Hengy/RelayAnalyzerHardware/Hardware Block Diagram.jpg

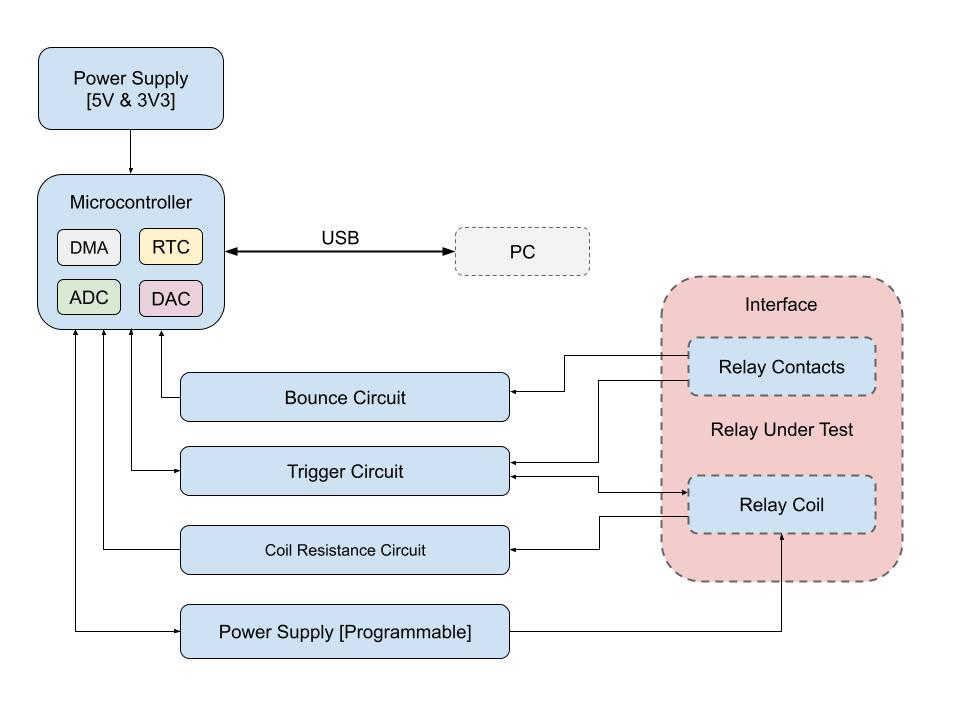
Hardware Block Diagram.jpg
