Hengy/RelayAnalyzerHardware/Photos/Programmable Power Supply.jpg

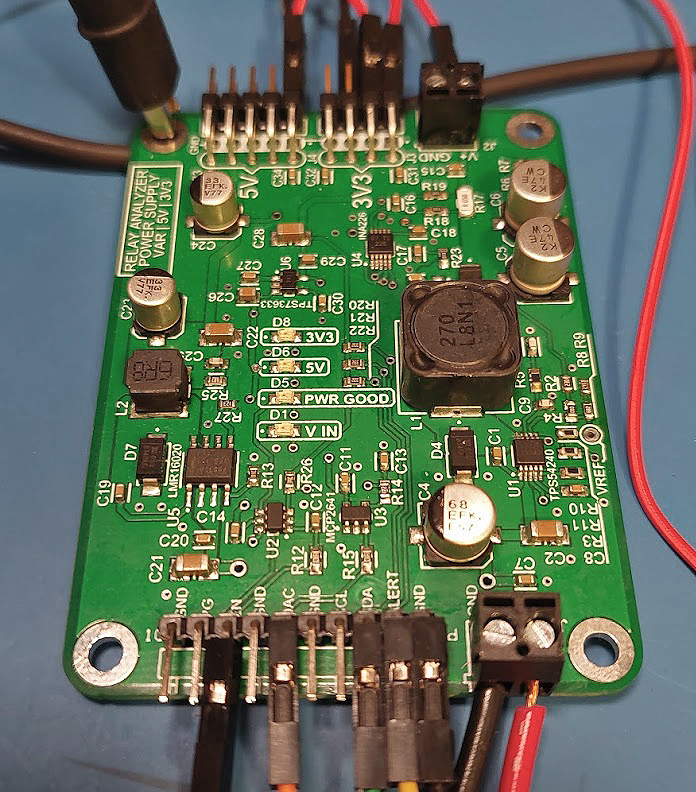
Photos/Programmable Power Supply.jpg
