Hengy/RelayAnalyzerHardware/Photos/STM32F767 Nucleo.jpg

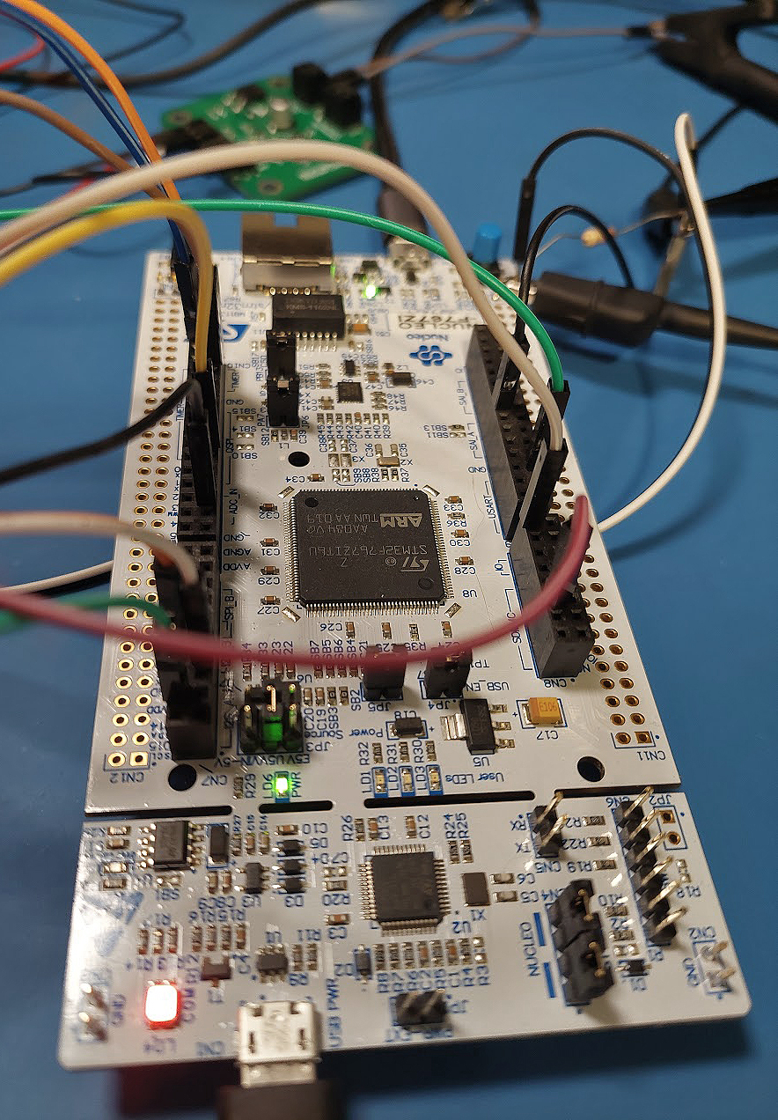
Photos/STM32F767 Nucleo.jpg
