Hengy/RelayAnalyzerHardware/Photos/Trigger.jpg

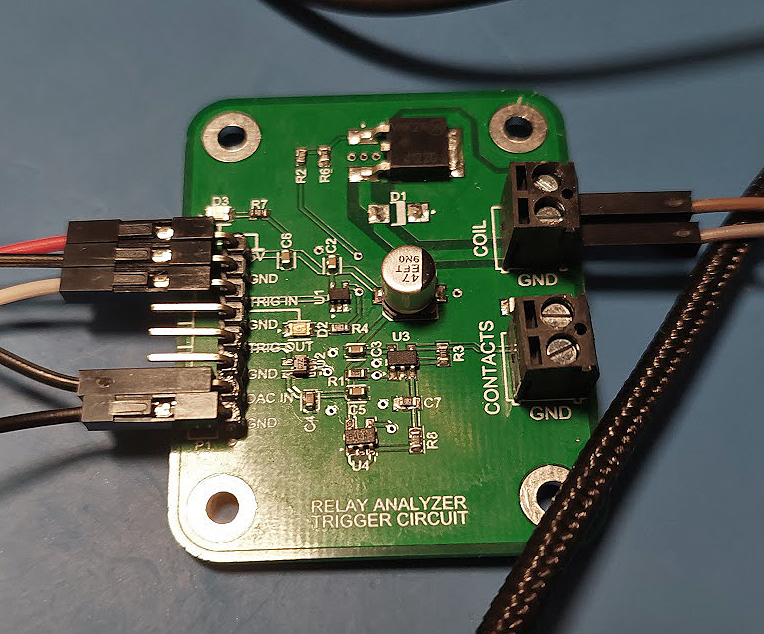
Photos/Trigger.jpg
