Hengy/RelayAnalyzerHardware/Trigger Circuit/PCB.jpg

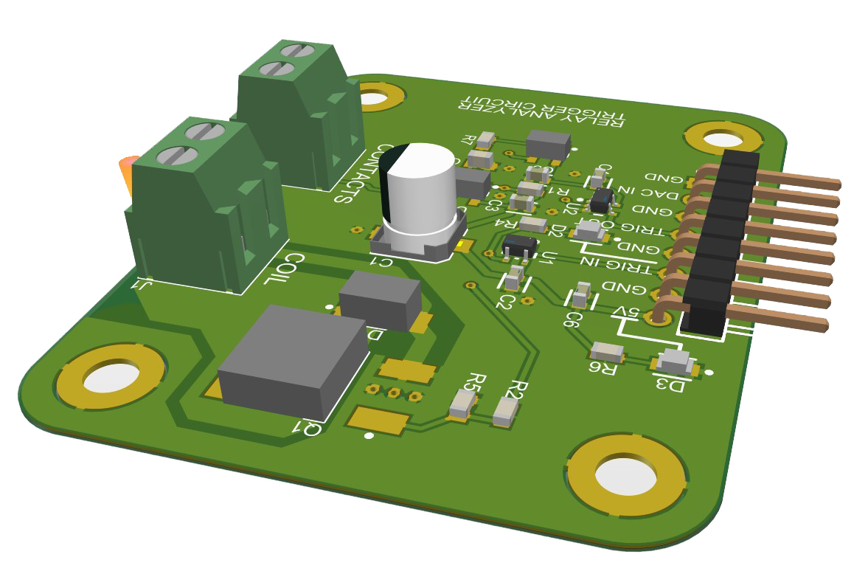
Trigger Circuit/PCB.jpg
