Hengy/RelayAnalyzerHardware/Programmable Power Supply/BOM.xlsx

Designator | Quantity | Comment | Description | PartType | Case Code (Imperial) | Case/Package | Package | PackageDescription | PackageReference | Manufacturer
C1, C3, C7, C11, C12, C14, C15, C17, C18, C19, C20, C27, C29, C31, C32, C33, C34 | 17 | CL10B104KA8NFNC | Cap Ceramic 100nF 25V X7R ±10% Pad SMD 0603 +125°C T/R | CL10B104KA8NFNC | 0603 | 0603
C2, C21, C22, C28 | 4 | GCJ31CR71E475KA12L | Cap Ceramic 4.7uF 25V X7R 10% Pad SMD 1206 Soft Termination +125°C Automotive T/R | GCJ31CR71E475KA12L | 1206 | 1206
C4 | 1 | UUD1E680MCL1GS | Aluminum Electrolytic Capacitor, UD Series, Low Impedance, 68 uF, 25 V, + / - 20%, -55 to 105 degC, Chip Type, 6.3 x 5.8 mm D x L, Pb-Free, Reel | UUD1E680MCL1GS |  |  |  | 2-Pin Surface Mount Device, Diameter 6.3 mm, Height 5.8 mm, Pitch 5.4 mm | CAPAE-D6.3H5.8 | Nichicon
C5, C6 | 2 | UUD1E470MCL1GS | Aluminum Electrolytic Capacitor, UD Series, Low Impedance, 47 uF, 25 V, + / - 20%, -55 to 105 degC, Chip Type, 6.3 x 5.8 mm D x L, Pb-Free, Reel | UUD1E470MCL1GS |  |  |  | 2-Pin Surface Mount Device, Diameter 6.3 mm, Height 5.8 mm, Pitch 5.4 mm | CAPAE-D6.3H5.8 | Nichicon
C8 | 1 | 06035C103MAT2A |  | 06035C103MAT2A |  |  |  |  |  | AVX Interconnect / Elco
C9 | 1 | CL10C220JB8NNNC | Chip Capacitor, 22 pF, +/- 5%, 50 V, -55 to 125 degC, 0603 (1608 Metric), RoHS, Tape and Reel | CL10C220JB8NNNC |  |  |  |  |  | Samsung Electro-Mechanics
C10 | 1 | CL10B392KB8NNND | Cap Ceramic 3.9nF 50V X7R ±10% Pad SMD 0603 +125°C T/R | CL10B392KB8NNND |  | 0603
C13, C30 | 2 | CL10B103MB8NNNC | Cap Ceramic 10nF 50V X7R ±20% Pad SMD 0603 +125°C T/R | CL10B103MB8NNNC | 0603 | 0603
C16 | 1 | C0603C104J4RACTU | CAP CER 0.1UF 16V X7R 0603 | C0603C104J4RACTU |  |  | C0603C-CF |  |  | KEMET
C23, C24 | 2 | UUD1A330MCL1GS | Aluminum Electrolytic Capacitor, UD Series, Low Impedance, 33 uF, 10 V, + / - 20%, -55 to 105 degC, Chip Type, 5 x 5.8 mm D x L, Pb-Free, Reel | UUD1A330MCL1GS |  |  |  | 2-Pin Surface Mount Device, Diameter 5 mm, Height 5.8 mm, Pitch 4.4 mm | CAPAE-D5H5.8 | Nichicon
C25 | 1 | GRM1885C1H221JA01J |  | GRM1885C1H221JA01J |  |  |  |  |  | Murata
C26 | 1 | CL21A225KPCLNNC | CL21 Series 0805 2.2uF 10V ±10% Tolerance X5R Multilayer Ceramic Chip Capacitor | CL21A225KPCLNNC | 0805 | 0805
D1, D5, D6, D8 | 4 | LTST-C171GKT | LED GREEN CLEAR CHIP SMD | LTST-C171GKT | 0805 | 0805
D2 | 1 | MBRA160T3G | Schottky Power Rectifier, 2-Pin SMA, Pb-Free, Tape and Reel | MBRA160T3G |  |  |  | 2-Pin Small Molded Package, J-Bend Lead, Body 2.605 x 4.315 mm | SMA-2-403D-02 | On Semiconductor
D3 | 1 | MBR130T1G | Schottky Power Rectifier, 2-Pin SOD-123, Pb-Free, Tape and Reel | MBR130T1G |  |  |  | 2-Pin SOD, Body 1.6 x 2.69 mm | SOD-123-2-425-04 | On Semiconductor
D4, D7 | 2 | SS14 | DIODE SCHOTTKY 40V 1A SMA | SS14 |  |  | 403AE |  |  | ON Semiconductor
J1, J2 | 2 | 691103110002 | Series 1031 - 3.50 mm Horizontal Entry Modular with Pressure Clamp WR-TBL, 2 pin | 691103110002 |  |  |  |  |  | Wurth Elektronik
J3 | 1 | TSW-104-08-T-D-RA | CONN HEADER R/A 8POS 2.54MM | TSW-104-08-T-D-RA |  |  | TSW-104-08-T-D-RA |  |  | Samtec
J4 | 1 | TSW-105-08-L-D-RA | CONN HEADER R/A 10POS 2.54MM | TSW-105-08-L-D-RA |  |  | TSW-105-08-L-D-RA |  |  | Samtec
L1 | 1 | CDRH127NP-100MC | Power Inductor, 10 uH, +/- 20%, -40 to 100 degC, 2-Pin SMD, RoHS, Tape and Reel | CDRH127NP-100MC |  |  |  |  |  | Sumida
L2 | 1 | SRN6045-2R2Y | Semi-Shielded Power Inductor, 2.2 uH, +/- 30%, 3.5 A, -40 to 125 degC, 2-Pin SMD, RoHS, Tape and Reel | SRN6045-2R2Y |  |  |  |  |  | Bourns
P1 | 1 | 61301011021 | THT Angled Pin Header WR-PHD, Pitch 2.54 mm, Single Row, 10 pins | 61301011021 |  |  |  |  |  | Wurth Elektronik
R1 | 1 | RC1608F682CS | Res Thick Film 0603 6.8kΩ 1% 0.1W ±100ppm/°C Molded SMD T/R | RC1608F682CS | 0603 | 0603
R2 | 1 | CRCW0603169KFKEA | RES Thick Film, 169kΩ, 1%, 0.1W, 100ppm/°C, 0603 | CRCW0603169KFKEA | 0603 | 0603
R3 | 1 | ERJ-3EKF1623V |  | ERJ-3EKF1623V |  |  |  |  |  | Panasonic
R4, R11 | 2 | ERJ-3EKF2551V |  | ERJ-3EKF2551V |  |  |  |  |  | Panasonic
R5 | 1 | 68K1 1% 0603(1608) | 68K1 0.1W 1% 0603 (1608 Metric) SMD | 68K1 1% 0603(1608)
R6, R7 | 2 | RC3216J102CS | Res Thick Film 1206 1kΩ 5% 0.25W ±100ppm/°C Molded SMD T/R | RC3216J102CS | 1206 | 1206
R8, R9 | 2 | RC0603FR-135K6L |  | RC0603FR-135K6L |  |  |  |  |  | Yageo
R10 | 1 | RC1608F753CS | Res Thick Film 0603 75kΩ 1% 0.1W ±100ppm/°C Molded SMD T/R | RC1608F753CS | 0603 | 0603
R12, R15 | 2 | CRCW0603100RFKEB | RES Thick Film, 100Ω, 1%, 0.1W, 100ppm/°C, 0603 | CRCW0603100RFKEB | 0603 | 0603
R13 | 1 | CRCW060310K0JNEB | RES Thick Film, 10kΩ, 5%, 0.1W, 200ppm/°C, 0603 | CRCW060310K0JNEB | 0603 | 0603
R14 | 1 | 3K3 5% 0603(1608) | 3K3 0.1W 5% 0603 (1608 Metric) SMD | 3K3 5% 0603(1608)
R16 | 1 | ERJ-3GEYJ681V |  | ERJ-3GEYJ681V |  |  |  |  |  | Panasonic
R17 | 1 | RP73D2B100RBTDF | Res Thin Film 1206 100Ω 0.1% 0.25W 15ppm/°C Molded SMD | RP73D2B100RBTDF |  |  | RP732B |  |  | TE Connectivity
R18, R19, R23 | 3 | TNPW060310R0FHTA |  | TNPW060310R0FHTA |  |  |  |  |  | Vishay Dale
R20, R21, R22 | 3 | ERJ-3GEYJ332V |  | ERJ-3GEYJ332V |  |  |  |  |  | Panasonic
R24 | 1 | AC0603FR-071K3L | RES SMD 1.3K OHM 1% 1/10W 0603 | AC0603FR-071K3L |  |  | AC0603 |  |  | Yageo
R25 | 1 | CRCW060368K0FKEA | RES Thick Film, 68kΩ, 1%, 0.1W, 100ppm/°C, 0603 | CRCW060368K0FKEA | 0603 | 0603
R26 | 1 | CRCW060322K1FKTA |  | CRCW060322K1FKTA |  |  |  |  |  | Vishay Dale
R27 | 1 | RC0603FR-1312KL |  | RC0603FR-1312KL |  |  |  |  |  | Yageo
R28 | 1 | ERJ-3GEYJ561V |  | ERJ-3GEYJ561V |  |  |  |  |  | Panasonic
U1 | 1 | TPS54240DGQR | Buck Inverting Buck-Boost Step Down Regulator with 3.5 to 42 V Input and 0.8 to 39 V Output, -40 to 150 degC, 10-Pin MSOP-PowerPAD (DGQ), Green (RoHS & no Sb/Br) | TPS54240DGQR |  |  |  | 10-Pin PowerPAD Plastic Small Outline 0.5 mm Pitch, Exposed Pad | DGQ0010D | Texas Instruments
U2 | 1 | SN74LVC2G17DBVR | Dual Schmitt-Trigger Buffer, DBV0006A, LARGE T&R | SN74LVC2G17DBVR |  |  |  |  | DBV0006A | Texas Instruments
U3 | 1 | MCP6241T-E/OT | 20 uA, 300 KHz Rail-to-Rail Operational Amplifier, 5-Pin SOT-23, Extended Temperature, Tape and Reel | MCP6241T-E/OT |  |  |  | 5-Lead Plastic Small Outline Transistor (OT) [SOT-23] | SOT-23-OT5
U4 | 1 | INA226AIDGST | High-Side Measurement, Bi-Directional Current / Power Monitor with I2C Interface, 2.7 to 5.5 V, -40 to 125 degC, 10-pin SOP (DGS10), Green (RoHS & no Sb/Br) | INA226AIDGST |  |  |  | 10-Pin Plastic Small Outline, Body 3 x 3 mm, Pitch 0.5 mm | DGS0010A
U5 | 1 | LMR16020PDDAR | IC REG BUCK ADJUSTABLE 2A 8SOPWR | LMR16020PDDAR |  |  | DDA0008E |  |  | Texas Instruments
U6 | 1 | TPS73633DBVT | Single Output Low Noise LDO, 400 mA, Fixed 3.3 V Output, 1.7 to 5.5 V Input, with Reverse Current Protection, 5-pin SOT-23 (DBV), -40 to 85 degC, Green (RoHS & no Sb/Br) | TPS73633DBVT |  |  |  | 5-Pin Plastic Small Outline, Body 1.60 Ãƒâ€” 2.90 mm, Pitch 0.95 mm | DBV0005A | Texas Instruments
