Hengy/RelayAnalyzerHardware/Relay Interface/BOM.xlsx

Comment | Description | Designator | Quantity | Case/Package | Case Code (Imperial) | Package | PackageDescription | PartType | Manufacturer
CL10B104KB8NNNC | Multi-layer Ceramic Capacitor, -55 to 125 degC, 2-Pin SMD (0603), RoHS, Tape and Reel | C1, C3, C4, C6 | 4 |  |  |  |  | CL10B104KB8NNNC | Samsung Electro-Mechanics
UUD1C680MCL1GS | Aluminum Electrolytic Capacitor, UD Series, Low Impedance, 68 uF, 16 V, + / - 20%, -55 to 105 degC, Chip Type, 6.3 x 5.8 mm D x L, Pb-Free, Reel | C2 | 1 |  |  |  | 2-Pin Surface Mount Device, Diameter 6.3 mm, Height 5.8 mm, Pitch 5.4 mm | UUD1C680MCL1GS | Nichicon
GRM31CR61E106KA12L | Chip Capacitor, 10 uF, +/- 10%, 25 V, -55 to 85 degC, 1206 (3216 Metric), RoHS, Tape and Reel | C5 | 1 |  |  |  |  | GRM31CR61E106KA12L | Murata
LTST-C171KGKT | LED GREEN CLEAR SMD | D1 | 1 | 0805 | 0805 |  |  | LTST-C171KGKT
LTST-C171GKT | LED GREEN CLEAR CHIP SMD | D2 | 1 | 0805 | 0805 |  |  | LTST-C171GKT
ES3AB-13-F | DIODE GEN PURP 50V 3A SMB | D3 | 1 |  |  | SMB |  | ES3AB-13-F | Diodes
691214110002 | Serie 2141 - 3.50 mm Horizontal Entry Modular with Rising Cage Clamp WR-TBL, 2 pin | J1, J3, J4, J5, J6, J7, J8, J9 | 8 |  |  |  |  | 691214110002 | Wurth Elektronik
90121-0768 | CONN HEADER R/A 8POS 2.54MM | J2 | 1 |  |  | HDR8 |  | 90121-0768 | Molex
CRCW06030000Z0EC |  | R1 | 1 |  |  |  |  | CRCW06030000Z0EC | Vishay Dale
RT0603BRD07560RL | RES SMD 560 OHM 0.1% 1/10W 0603 | R2, R3 | 2 |  |  | RT0603 |  | RT0603BRD07560RL | Yageo
RT0603BRD071K8L | RES SMD 1.8K OHM 0.1% 1/10W 0603 | R4, R5, R7, R8, R9 | 5 |  |  | RT0603 |  | RT0603BRD071K8L | Yageo
SN74LVC3G17DCUR | IC BUFFER NON-INVERT 5.5V US8 | U1, U2 | 2 |  |  | DCU0008A |  | SN74LVC3G17DCUR | Texas Instruments
CPC1019N | Dual FET DC Solid State Relay | U3, U4, U6, U7, U8 | 5 |  |  |  |  | CPC1019N
