Hengy/RelayAnalyzerHardware/Trigger Circuit/BOM.xlsx

Designator | Quantity | Comment | Description | Case/Package | Case Code (Imperial) | Manufacturer Part Number | Package | PackageDescription | PartType | Manufacturer
C1 | 1 | EEE-FT1E470AR | Aluminum Electrolytic Capacitor, 47 uF +/- 20%, 25 V, -55 to 105 degC, 2-Pin 5.3 x 5.3 x 6.1 mm SMD, RoHS, Tape and Reel |  |  |  |  | 2-Pin SMD, Body 5.3 x 5.3 mm, Height 6.1 mm | EEE-FT1E470AR | Panasonic
C2, C3, C4, C5, C6 | 5 | C0603C104K4RACTU | Capacitor; Ceramic; Cap; .100uF; Tol 10%; SMT; Vol-Rtg 16V; X7R; Tape and Reel |  |  | C0603C104K4RACTU | C0603C-CF |  | C0603C104K4RACTU | KEMET
C7 | 1 | VJ0603Y222KXACW1BC |  |  |  |  |  |  | VJ0603Y222KXACW1BC | Vitramon
D1 | 1 | 1SMA5913BT3G | 1.5 W Zener Voltage Regulator, 2-Pin SMA, Pb-Free, Tape and Reel |  |  |  |  | 2-Pin Small Molded Package, J-Bend Lead, Body 2.605 x 4.315 mm | 1SMA5913BT3G | On Semiconductor
D2, D3 | 2 | SML-LXT0805IW-TR | LED RED DIFFUSED SMD | 0805 | 0805 |  |  |  | SML-LXT0805IW-TR
J1, J2 | 2 | 691214110002 | Serie 2141 - 3.50 mm Horizontal Entry Modular with Rising Cage Clamp WR-TBL, 2 pin |  |  |  |  |  | 691214110002 | Wurth Elektronik
P1 | 1 | 61300811021 | THT Angled Pin Header WR-PHD, Pitch 2.54 mm, Single Row, 8 pins |  |  |  |  |  | 61300811021 | Wurth Elektronik
Q1 | 1 | MJD122T4G | Complementary Darlington Power Transistor, 3-Pin DPAK, Pb-Free, Tape and Reel |  |  |  |  | 3-Pin Flange Mount, Body 6.54 x 6.095 mm, Pitch 2.29 mm | MJD122T4G | On Semiconductor
R1, R4, R7 | 3 | ERJ-3EKF1001V |  |  |  |  |  |  | ERJ-3EKF1001V | Panasonic
R2 | 1 | ERJ-3EKF1000V |  |  |  |  |  |  | ERJ-3EKF1000V | Panasonic
R3, R6 | 2 | ERJ-3GEYJ103V |  |  |  |  |  |  | ERJ-3GEYJ103V | Panasonic
R5 | 1 | RC3216J102CS | Res Thick Film 1206 1kΩ 5% 0.25W ±100ppm/°C Molded SMD T/R | 1206 | 1206 |  |  |  | RC3216J102CS
R8 | 1 | ERJ-3GEYJ332V |  |  |  |  |  |  | ERJ-3GEYJ332V | Panasonic
U1, U2 | 2 | 74LVC1G17SE-7 | IC BUF NON-INVERT 5.5V SOT353 |  |  | 74LVC1G17SE-7 | SOT353 |  | 74LVC1G17SE-7 | Diodes
U3 | 1 | MCP6561RT-E/OT | 1.8V Low Power Push-Pull Output Comparator, 5-Pin SOT-23, Extended Temperature Range, Tape and Reel |  |  |  |  | 5-Lead Plastic Small Outline Transistor (OT) [SOT-23] | MCP6561RT-E/OT
U4 | 1 | MCP6001T-E/OT | 1 MHz, Low-Power Operational Amplifier, 5-Pin SOT-23, Extended Temperature, Tape and Reel |  |  |  |  | 5-Lead Plastic Small Outline Transistor (OT) [SOT-23] | MCP6001T-E/OT
