Hengy/RelayAnalyzerHardware/Photos/Test Setup.jpg

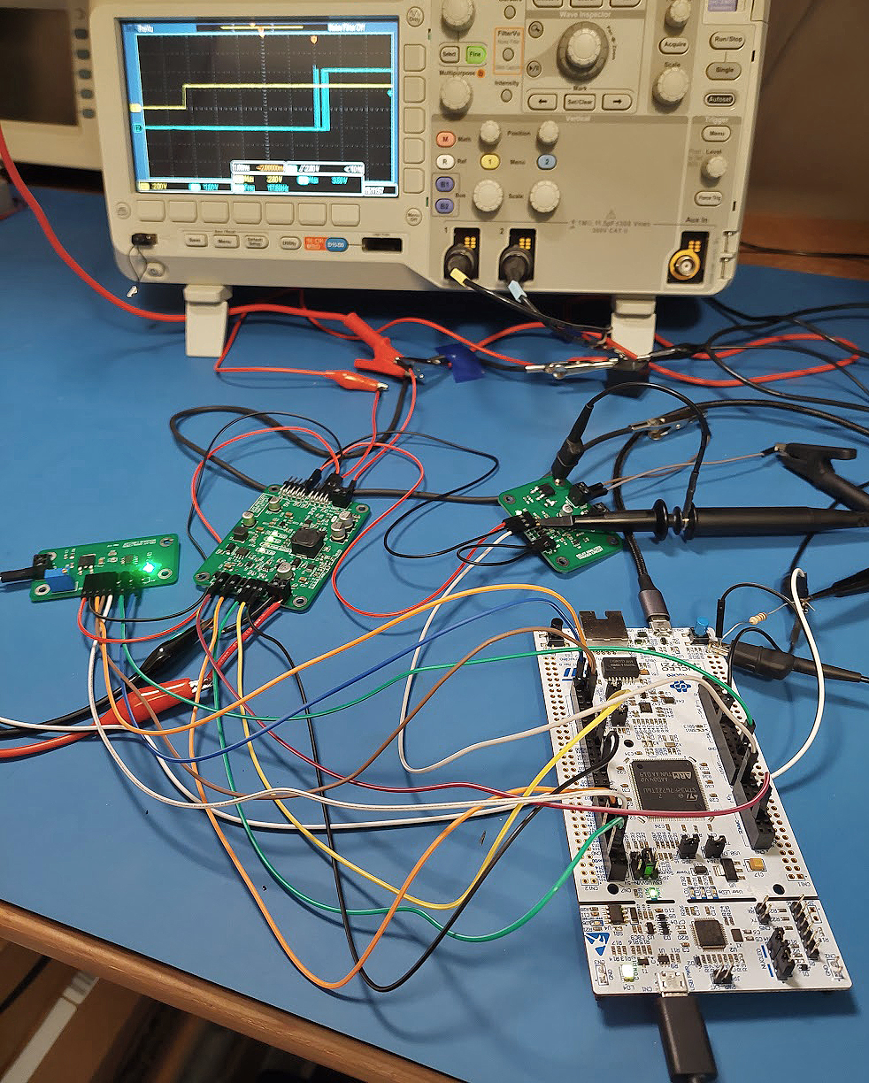
Photos/Test Setup.jpg
