Hengy/RelayAnalyzerHardware/Programmable Power Supply/Schematics and PCB.pdf

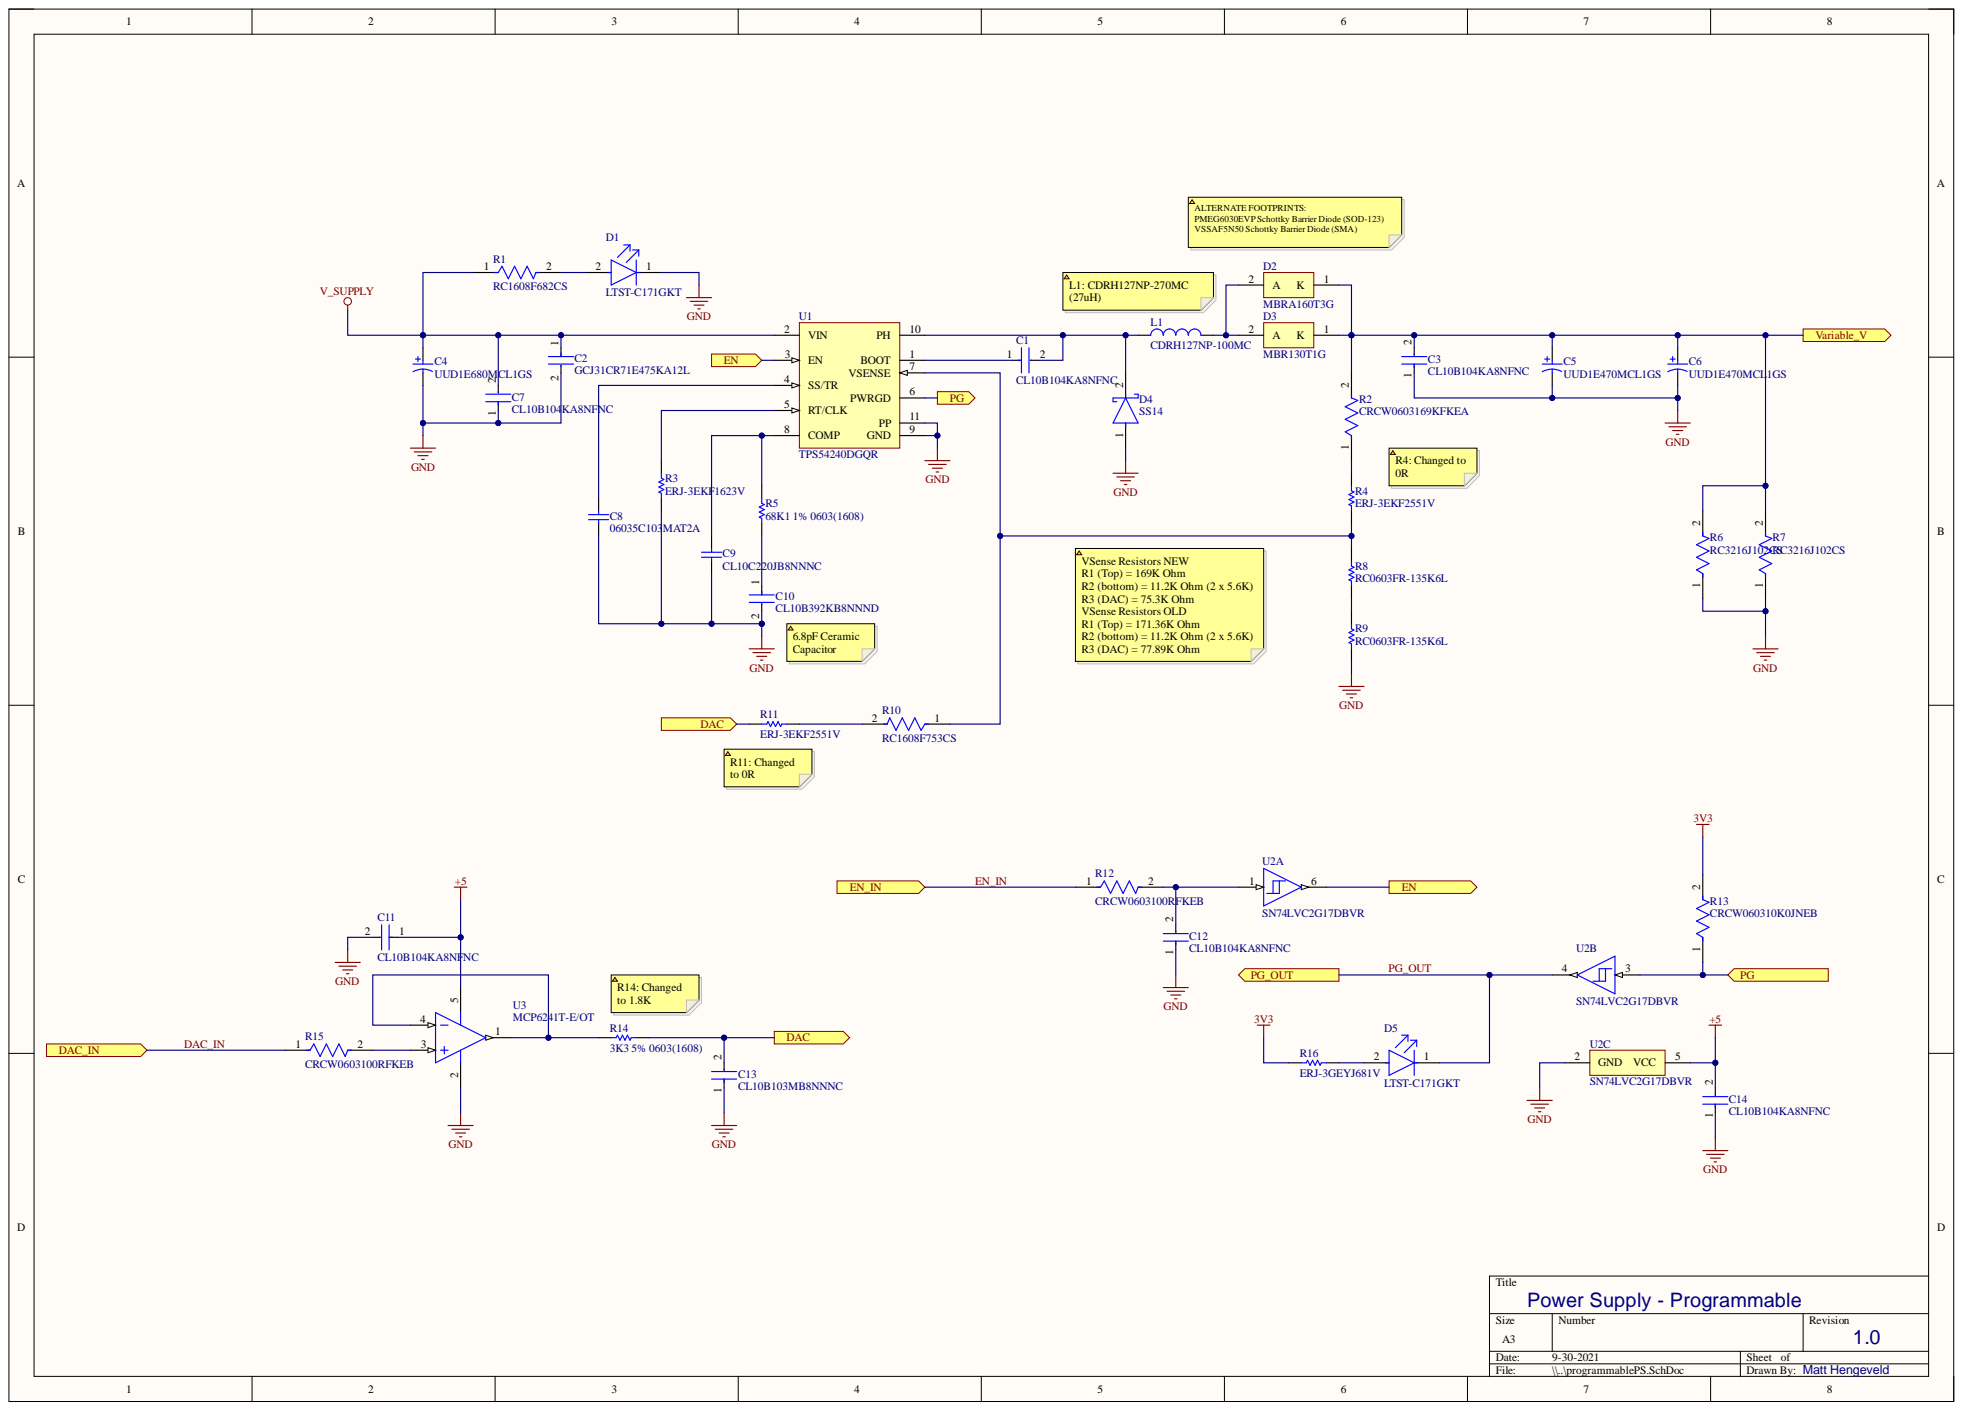
[picture p27: page 1]

ALTERNATE FOOTPRINTS:
PMEG6030EVPSchottky Barrier Diode (SOD-123)
VSSAF5N50 Schottky Barrier Diode (SMA)

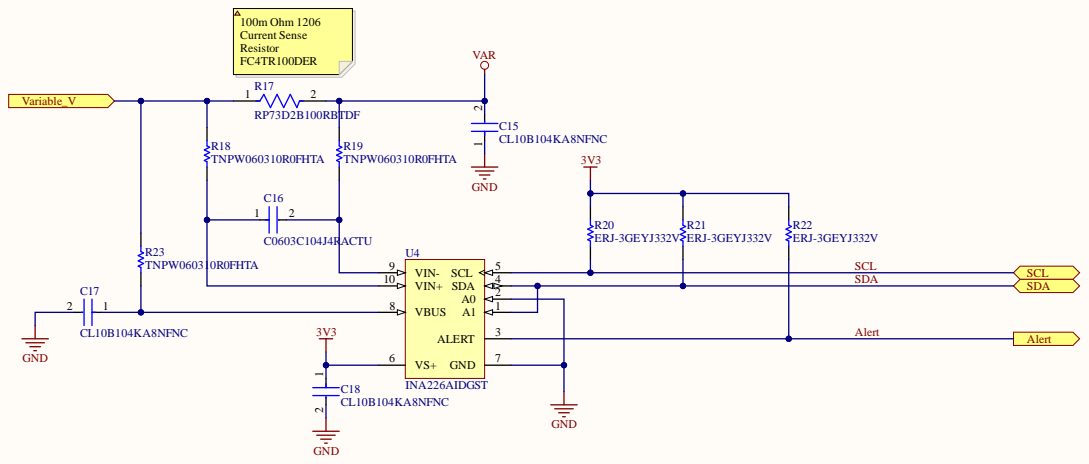
[picture p28: page 2]

Power Supply - Current Monitor

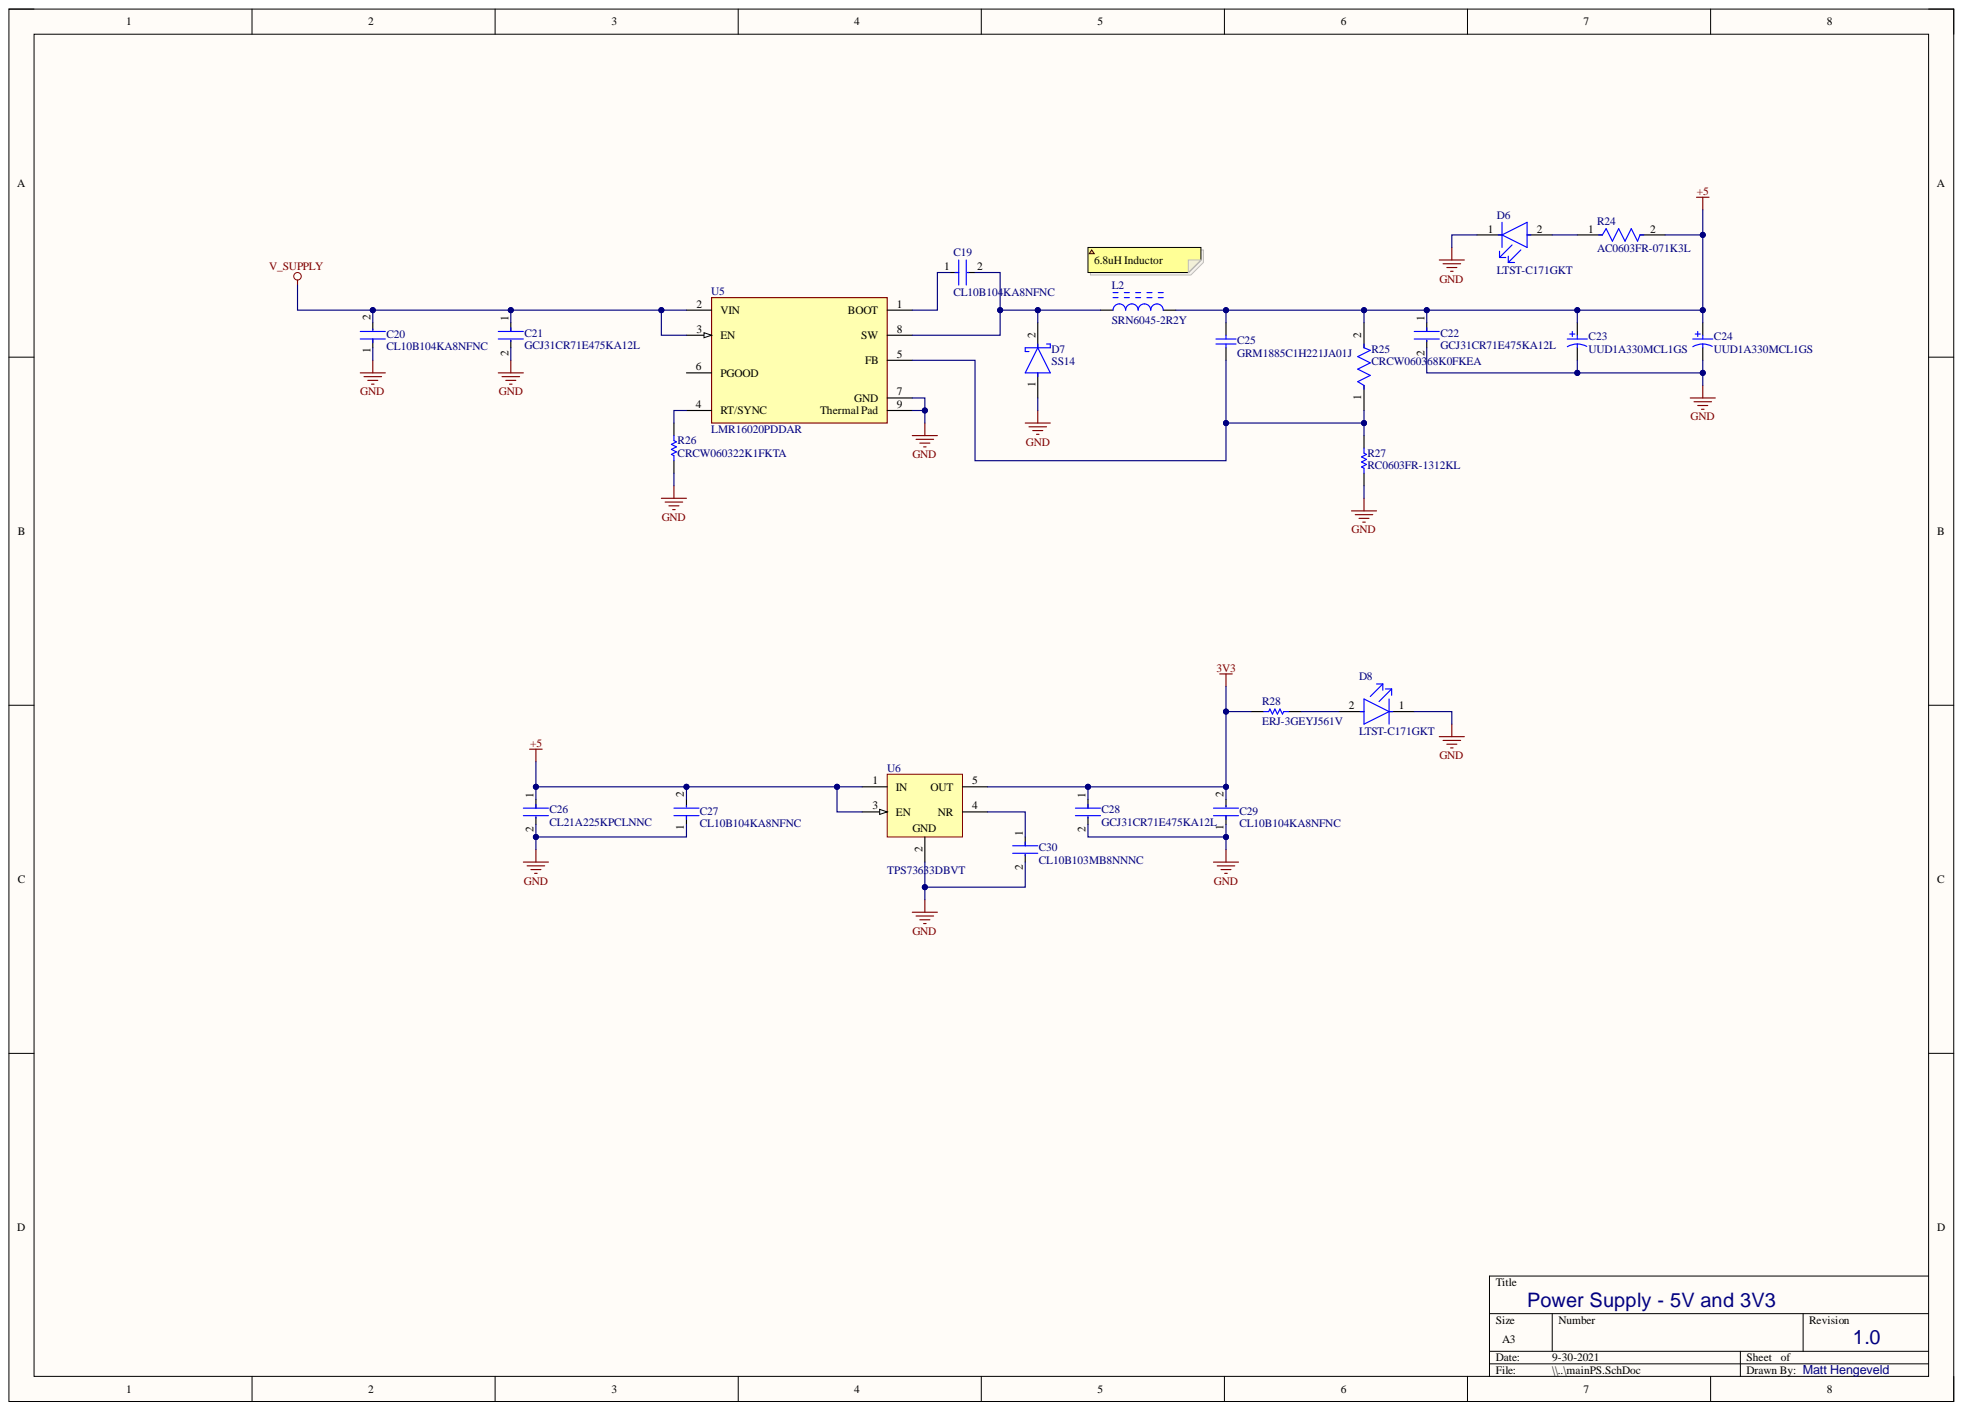
[picture p29: page 3]

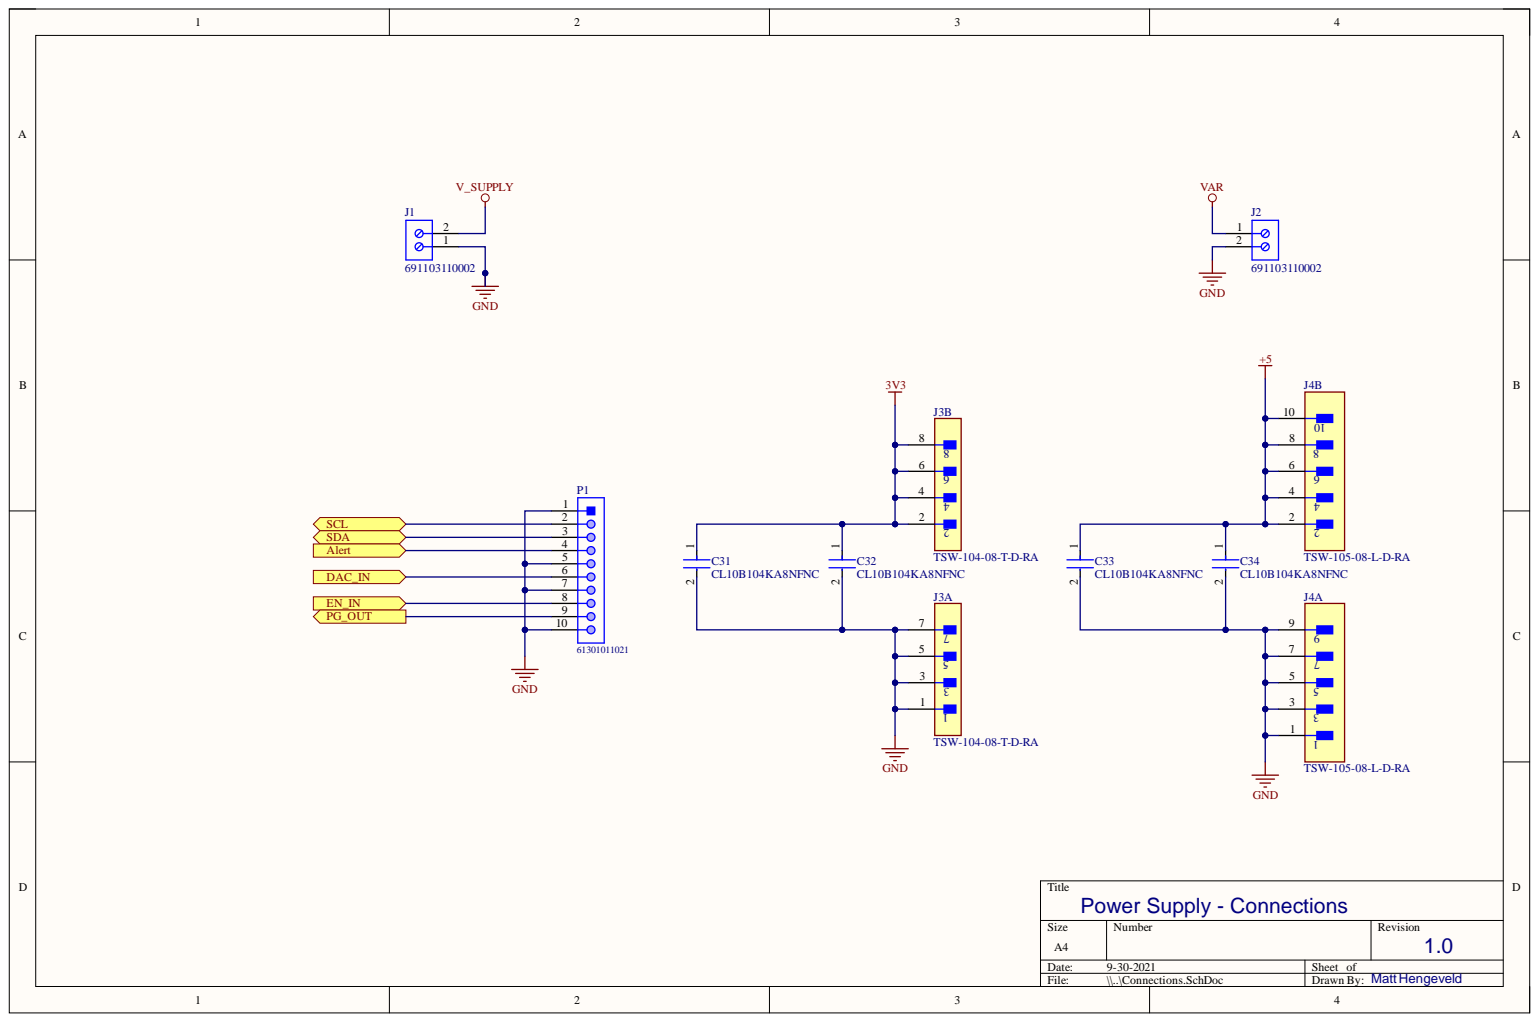
[picture p30: page 4]

10

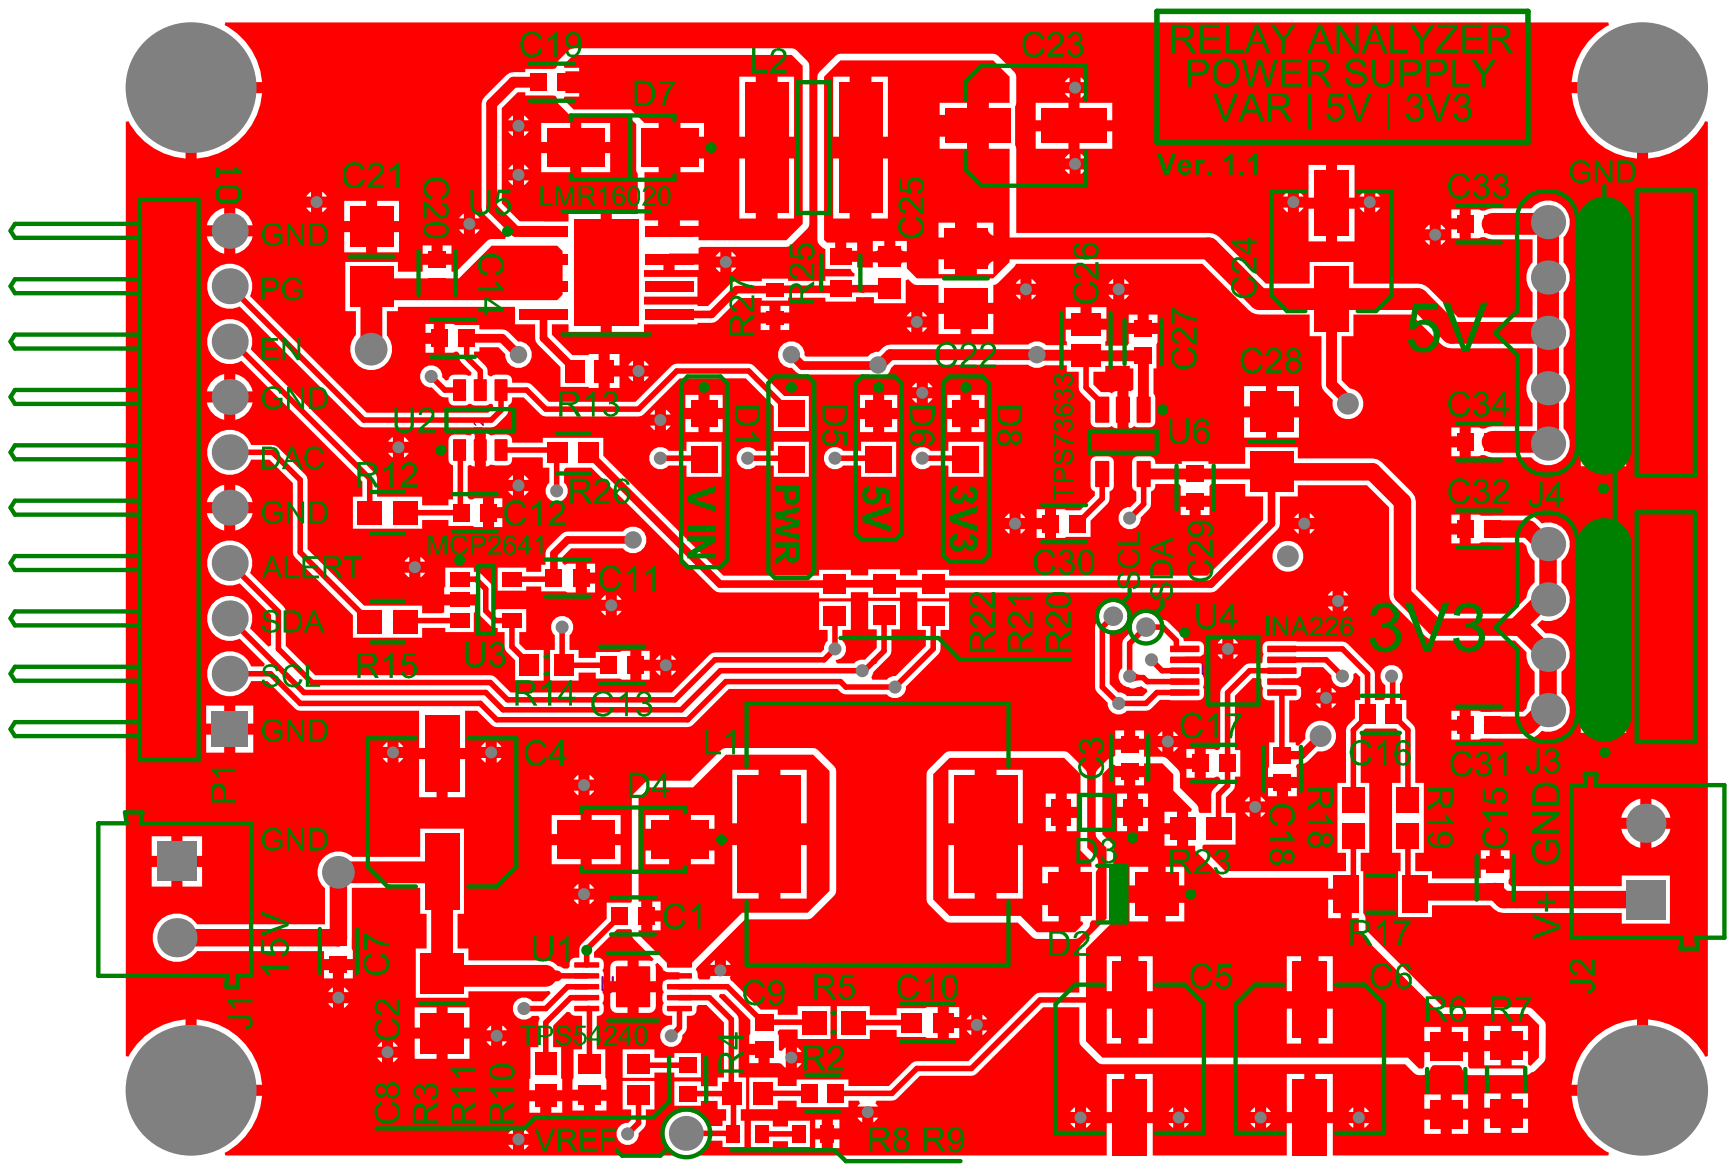
[picture p31: page 5]

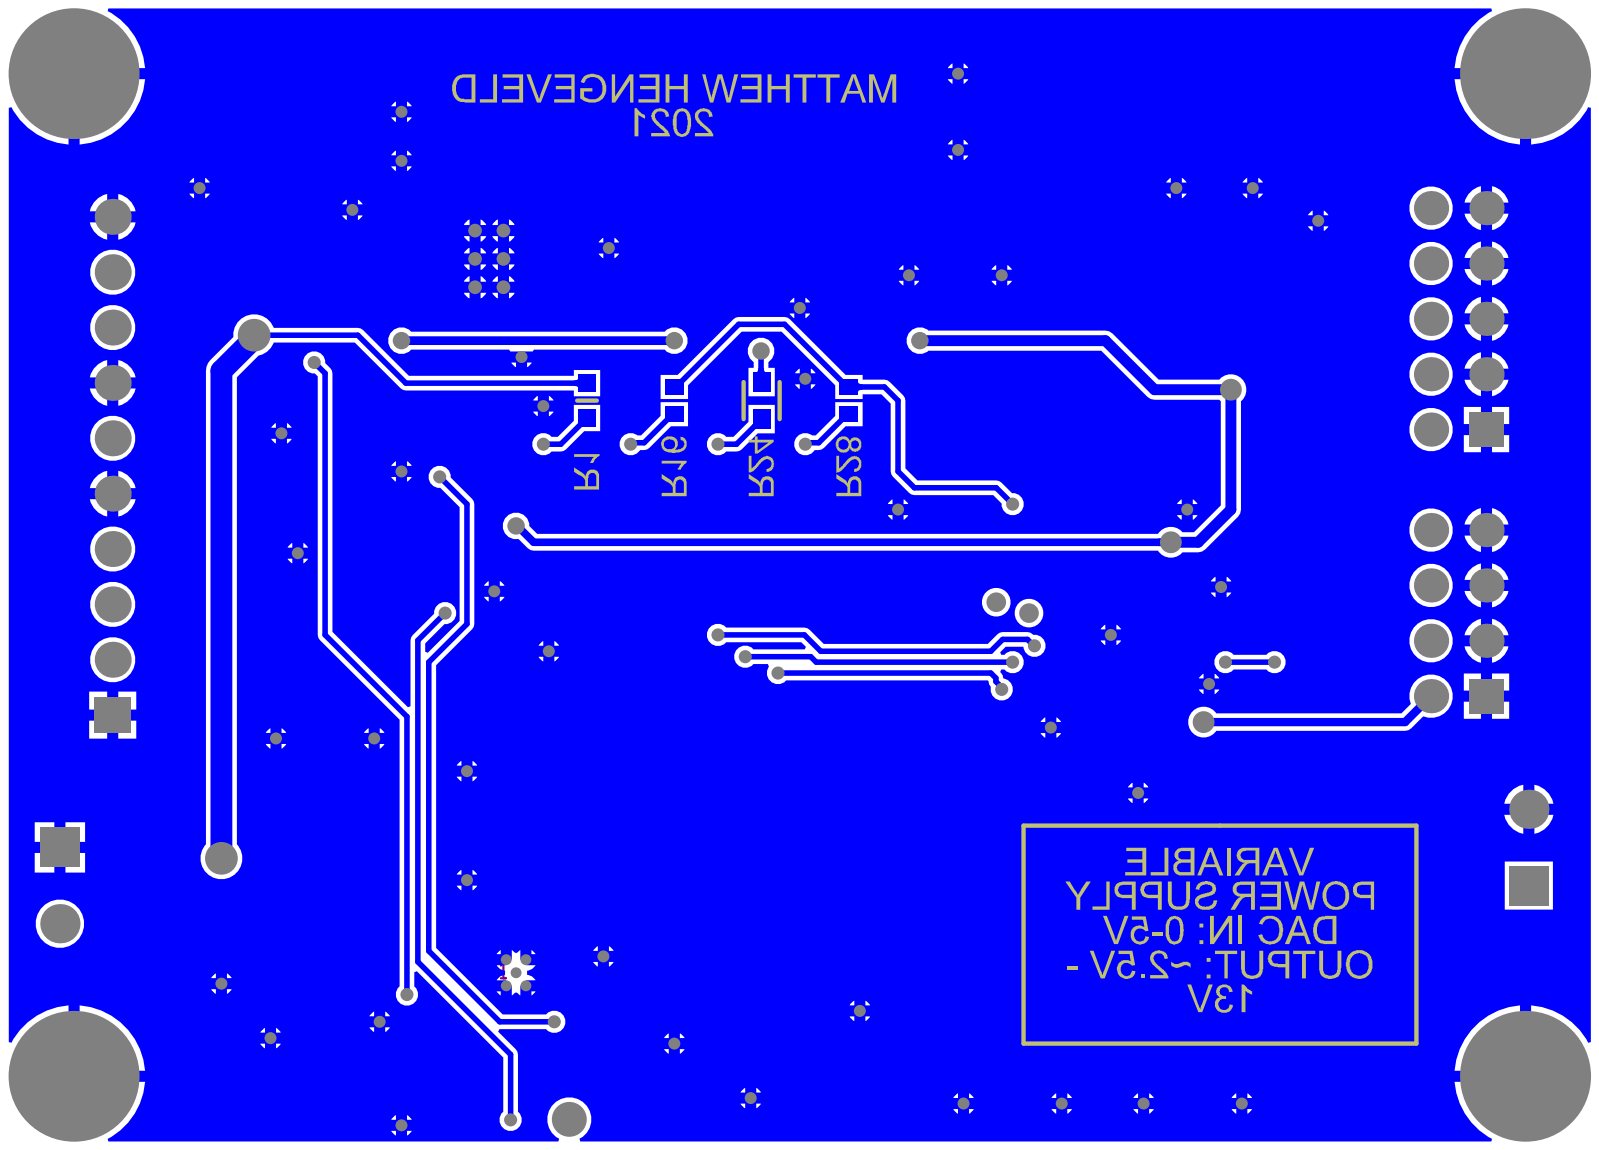
[picture p32: page 6]

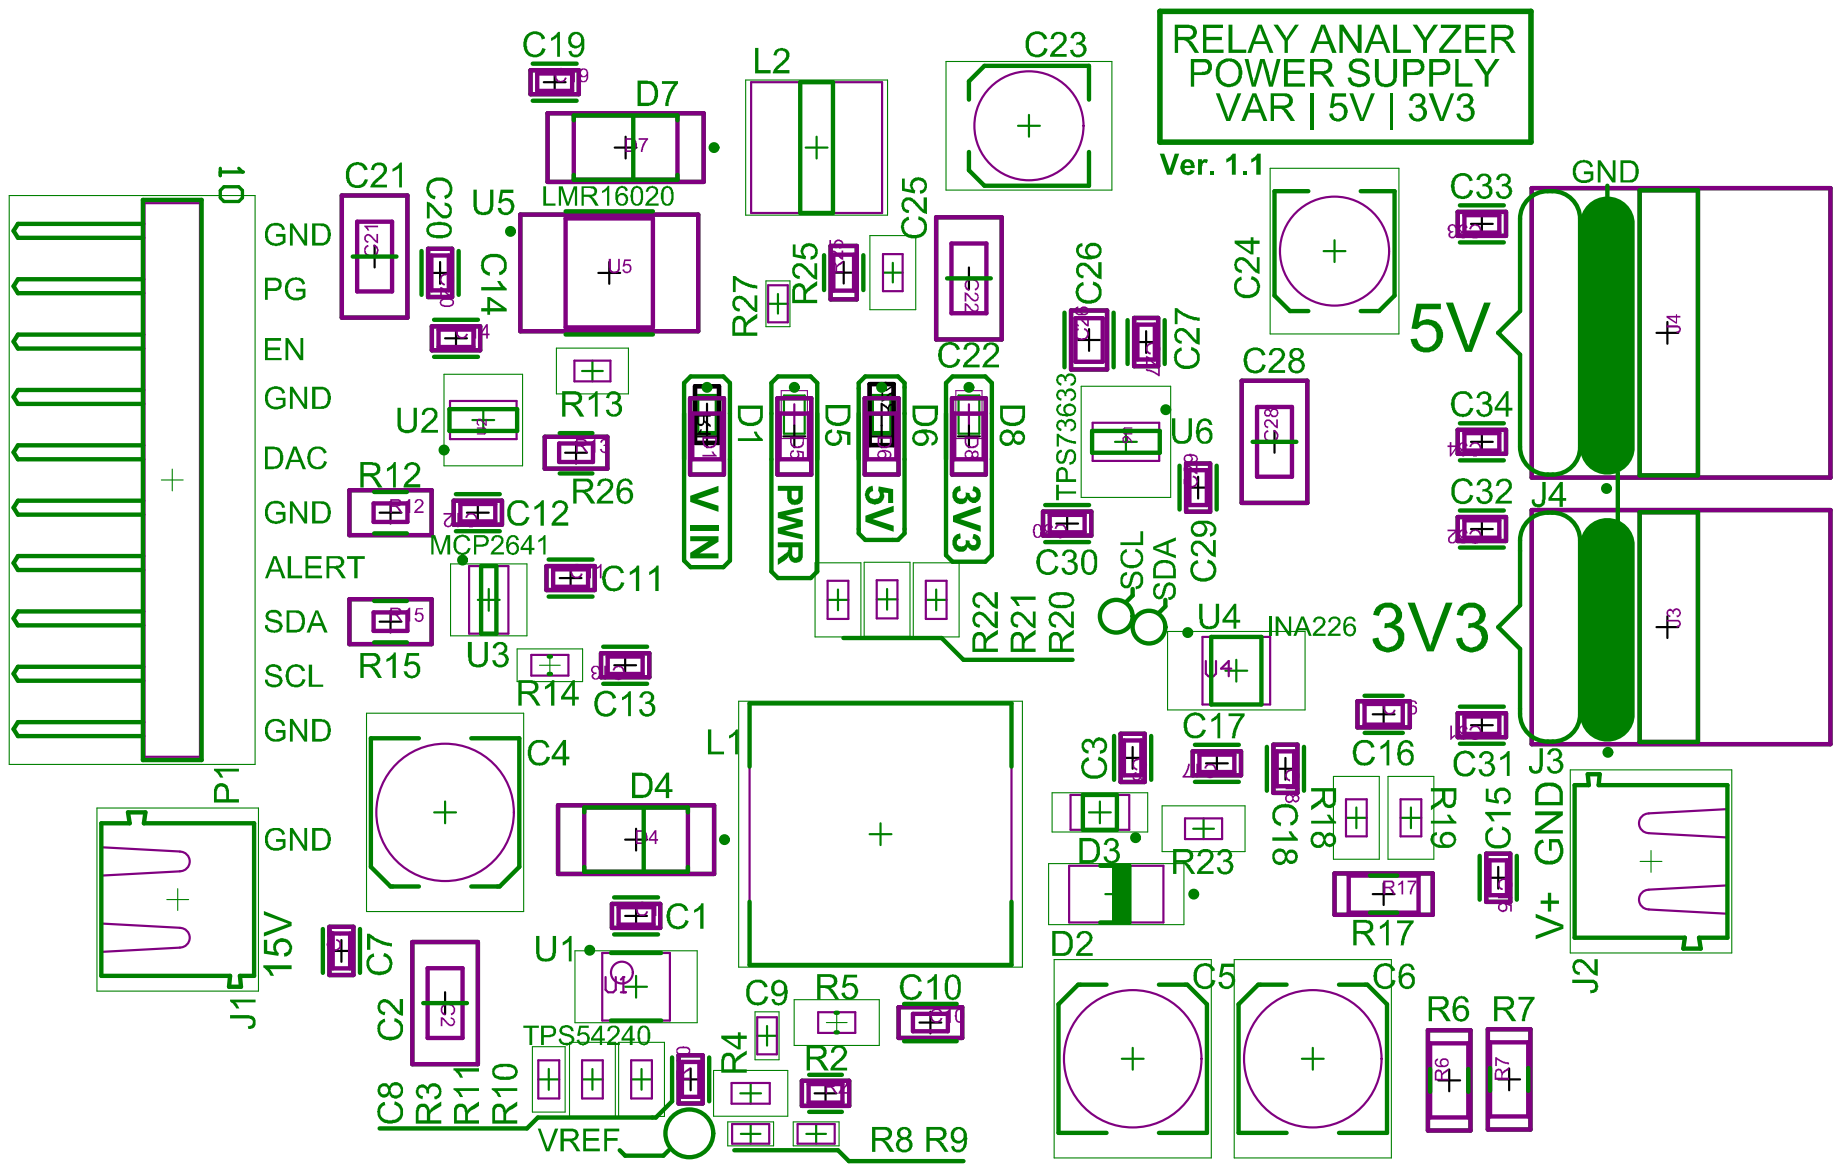
[picture p33: page 7]

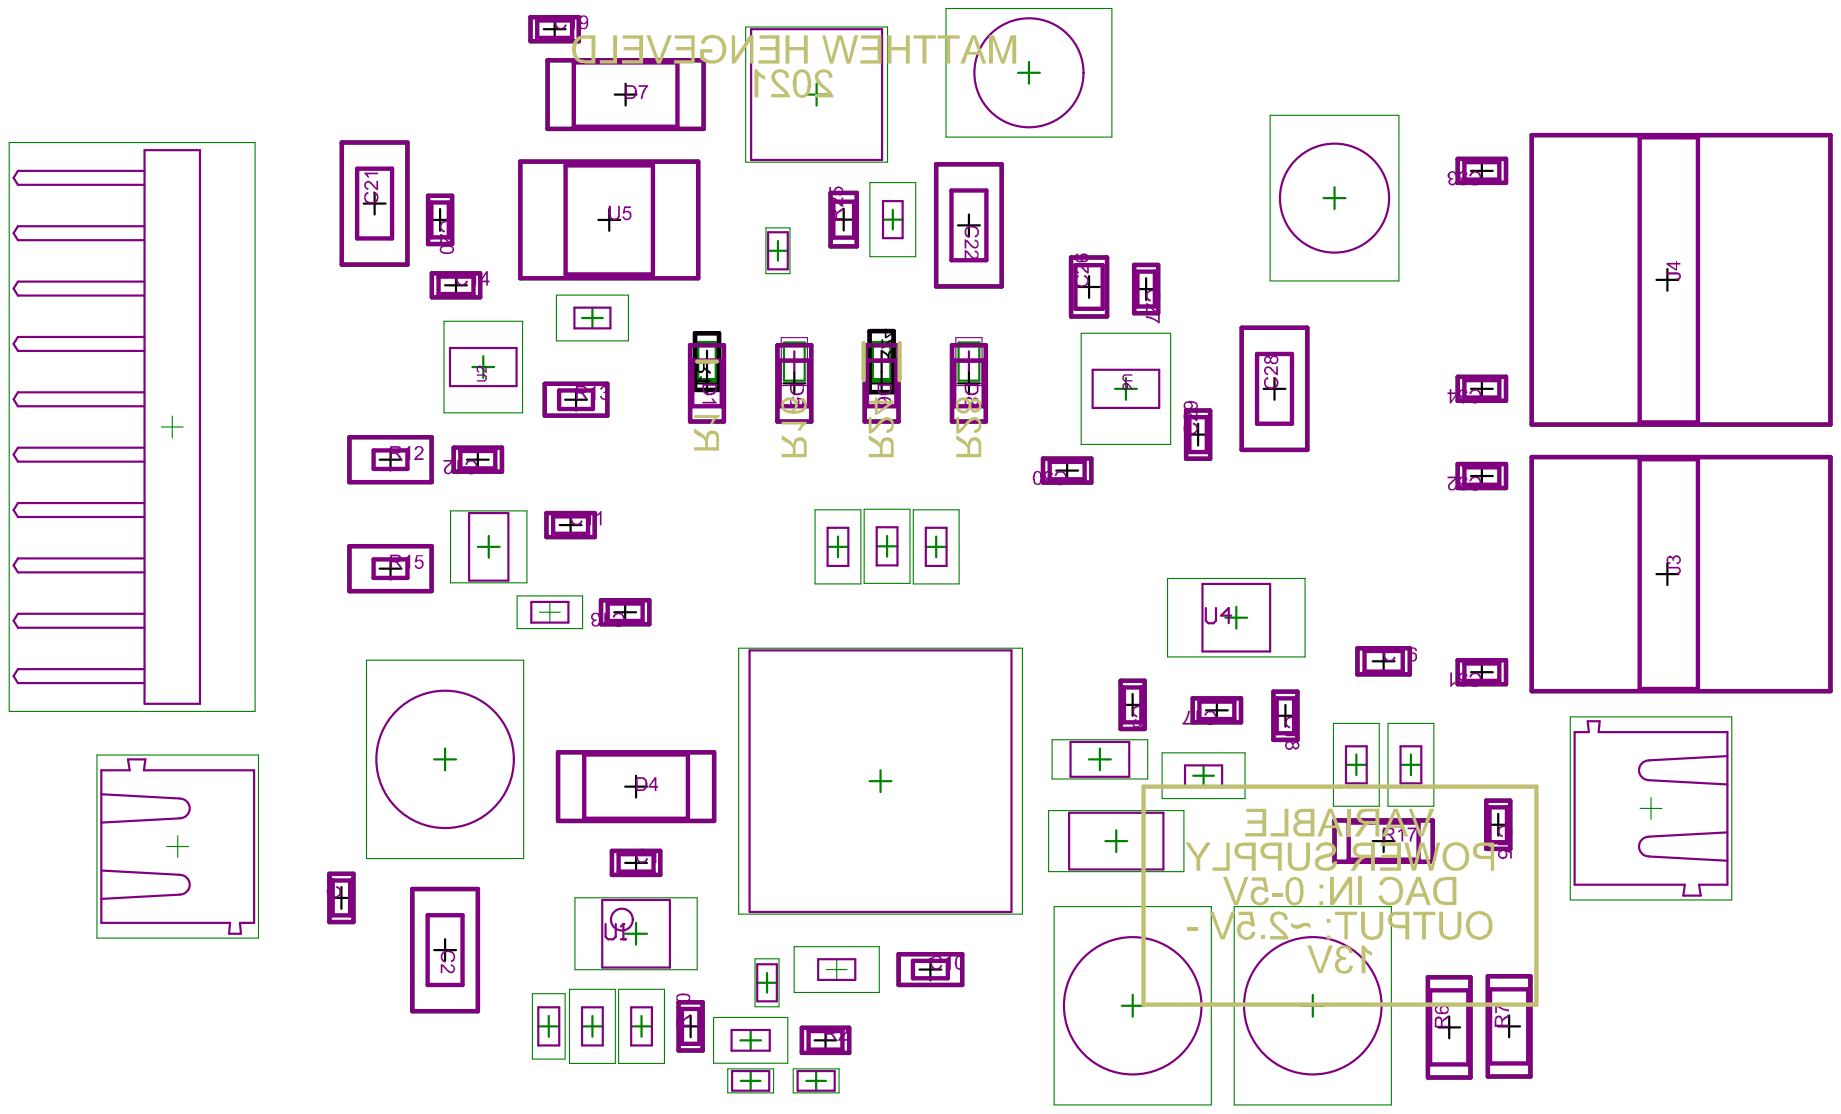
[picture p34: page 8]
