Hengy/RelayAnalyzerHardware/Relay Interface/schematic.pdf

# Coil Contacts

## Var Power

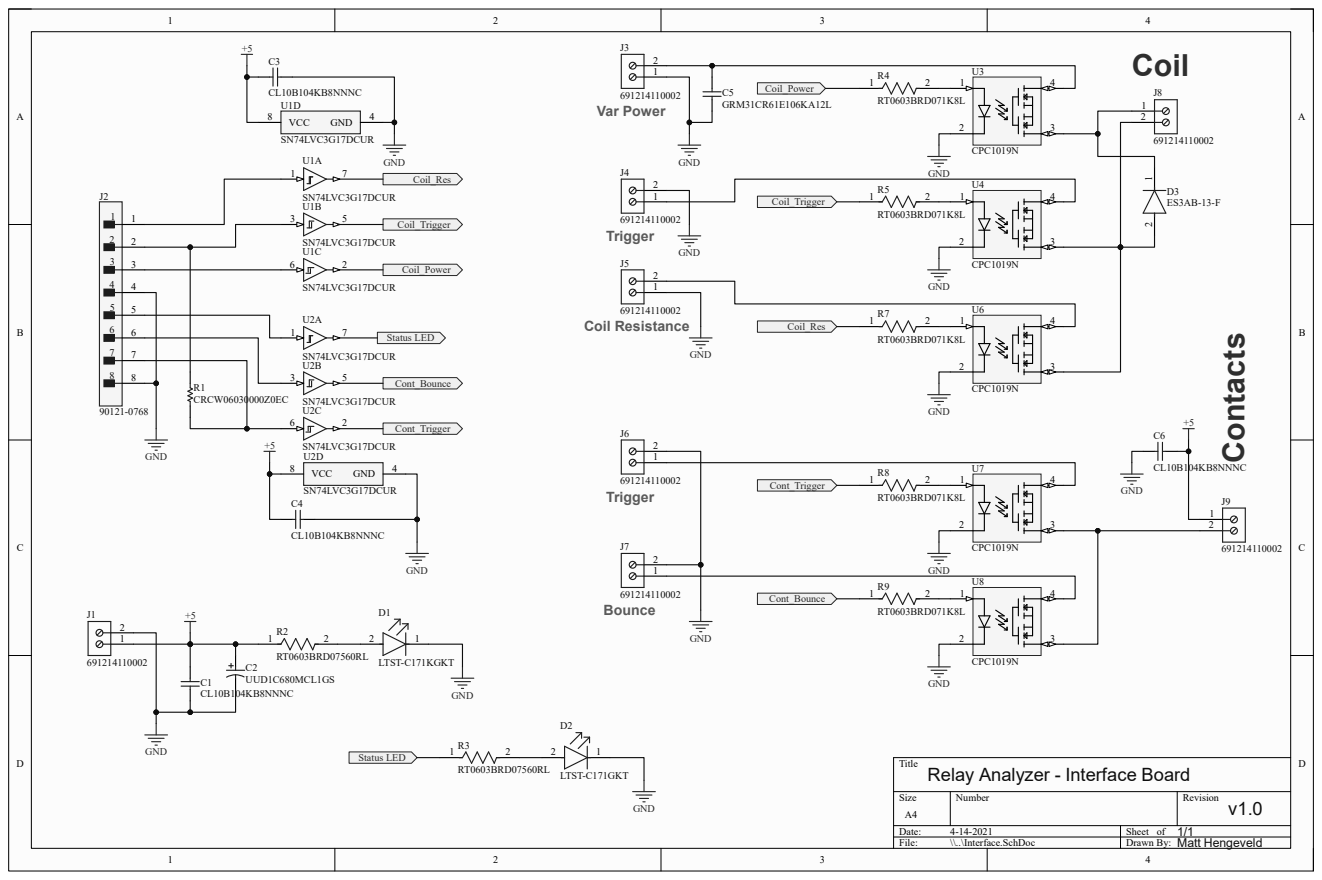
[picture p35: page 1]

Title
Relay Analyzer - Interface Board
