Hengy/RelayAnalyzerHardware/Trigger Circuit/schematic.pdf

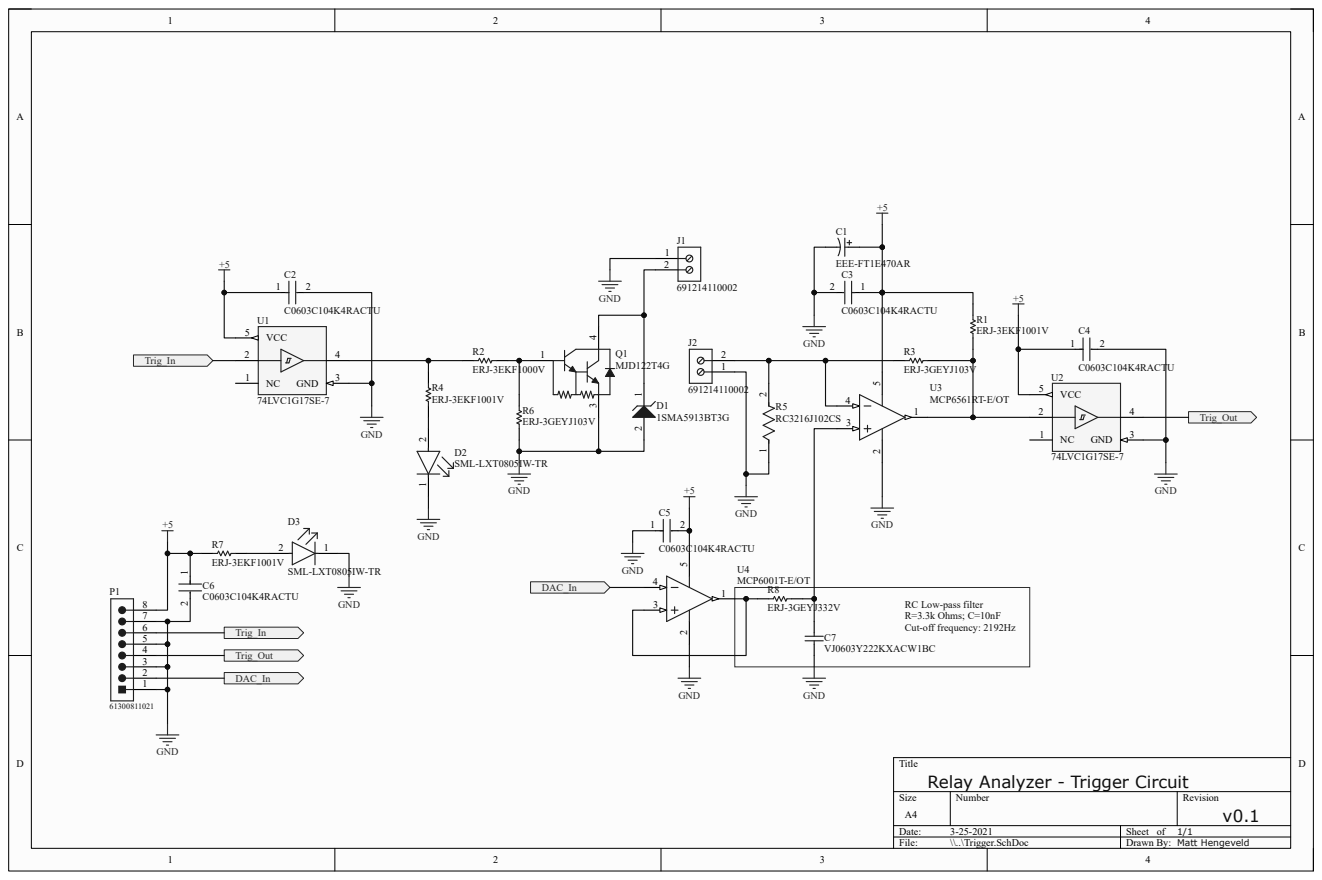
[picture p36: page 1]

RC Low-pass filter
