Hengy/RelayAnalyzerHardware/Connection Diagram.pdf

# STM32F767 NUCLEO

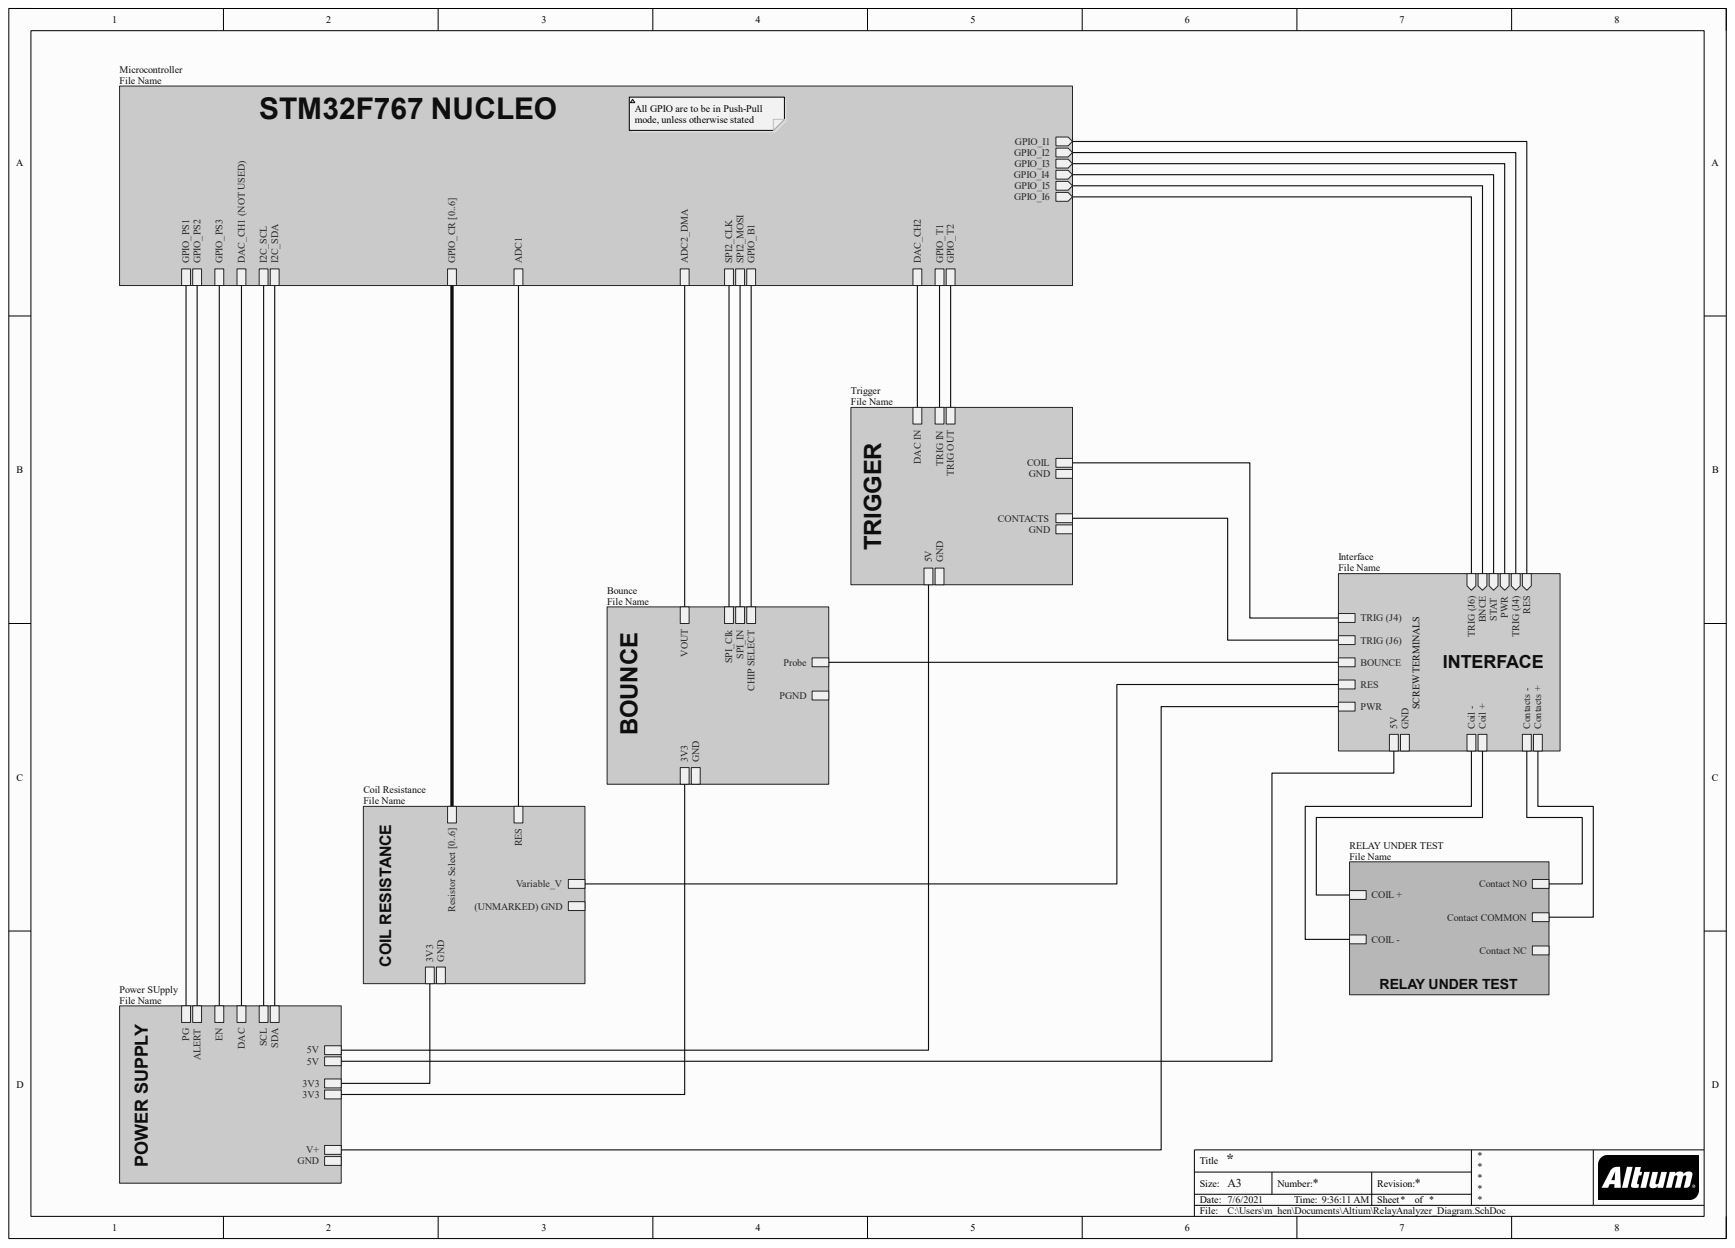
[picture p37: page 1]
C:\Users\m_hen\Documents\Altium\RelayAnalyzer_Diagram.SchDoc; Title; Size:; Number:; Date: File:; Revision:; Time:; Sheet; GPIO_I1 GPIO_I2 GPIO_I3 GPIO_I4 GPIO_I5; GPIO_I6 GPIO_PS¹ GPIO_PS²; GPIO_PS³; DAC_CH¹ ⁽NOT USED⁾; I2C_SCL I2C_SDA; GPIO_CR [0..6]; ADC¹; ADC²_DMA; SPI2_CLK SPI2_MOSI GPIO_B¹; DAC_CH²; GPIO_T¹ GPIO_T²; Microcontroller File Name; V+ GND; 3V3 PG ALERT; DAC; SCL SDA; Power SUpply File Name; Variable_V; (UNMARKED) GND 3V³ GND; RES Resistor Select [0..6]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

All GPIO are to be in Push-Pull
mode, unless otherwise stated

GND 5VGND TRIG IN TRIG OUT DAC IN

File Name TRIGGER BOUNCE COIL RESISTANCE POWER SUPPLY

RELAY UNDER TEST
