Hengy/RelayAnalyzerHardware/Firmware/Relay_Analyzer/Core/Src/main.c

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
/* Includes ------------------------------------------------------------------*/
#include "main.h"
#include "cmsis_os.h"

/* USER CODE BEGIN Includes */
#include <string.h>
#include <stdio.h>
//#include "MCP6S2.h"
#include "INA226.h"
#include "stream_buffer.h"
#include "usbd_core.h"
#include "usbd_desc.h"
#include "usbd_class.h"
/* USER CODE END Includes */

ADC_HandleTypeDef hadc1;
ADC_HandleTypeDef hadc2;
DMA_HandleTypeDef hdma_adc1;

DAC_HandleTypeDef hdac;

I2C_HandleTypeDef hi2c1;

RTC_HandleTypeDef hrtc;

SPI_HandleTypeDef hspi2;

TIM_HandleTypeDef htim6;

UART_HandleTypeDef huart3;

PCD_HandleTypeDef hpcd_USB_OTG_FS;

osThreadId_t defaultTaskHandle;
osThreadId_t processUSBTaskHandle;

USBD_HandleTypeDef hUsbDeviceFS;
StreamBufferHandle_t xStreamBuffer = NULL;

// GLOBAL ERROR
uint8_t gError = 0;

uint8_t running = 0;

// cyclesElapsed
uint32_t cyclesElapsed = 0;
uint32_t prevCycle = 0;

#define TIMER_MIN	0

// active test flags; all off
uint8_t bounceTest = 0;
uint8_t currentTest = 0;
uint8_t resistTest = 0;

int bounceTimer = 5;	// countdown number of cycles unitl next bounce test
int currentTimer = 4;	// countdown number of cycles unitl next coil current test
int resistTimer = 3;	// countdown number of cycles unitl next coil ressitance test
// -----------------------------------------------

// TEST RESULTS
// -----------------------------------------------
// INA226
uint8_t i2cBuf[3];
uint32_t i2cresults[4];	// results array: Bus Voltage, Shunt Voltage, Bus Current, Bus Power

// bounce data
uint16_t adc_buf[ADC_BUF_LEN];	// DMA buffer
uint8_t bounceDataReady = 0;	// bounce data ready flag

uint16_t coilResist = 0;

volatile uint8_t triggered = 0;		// activation/deactivation time interrupt flag
volatile uint16_t switchTime = 0;	// activation/deactivation time (timer ticks)

// -----------------------------------------------

// USB update packets
int usbPacketLen = 0;	// length of packet

// time
//char time[13];
//char date[6];

// timestamp struct
struct timestamp {
	uint16_t hours;
	uint8_t mins;
	uint8_t secs;
	uint8_t msecs;
} diffTime;

//struct timestamp startTime, endTime, currTime, prevTime;

// Update struct:
//
// timestamp:
//    timestamp (4 bytes),
// cycle number (4 bytes)
// activation time in us (4 bytes),
// deactivation time in us (4 bytes),
// INA226 bus voltage (2 bytes),
// INA226 shunt voltage (2 bytes),
// INA226 bus current (2 bytes),
// INA226 bus power (2 bytes),
// 12-bit coil resistance (2 bytes, padded left)
// Total: 40 bytes
struct updatePacket {
	struct timestamp ts;		// timestamp
	uint32_t cycle;				// current cycle number
	uint32_t act_t;				// activation time
	uint32_t deact_t;			// deactivation time
	uint16_t busV;				// INA226 bus voltage
	uint16_t shuntV;			// INA226 shunt voltage
	uint16_t busI;				// INA226 bus current
	uint16_t busP;				// INA226 bus power
	uint16_t coilR;				// coil resistance
	uint8_t bounceReady;		// bounce data ready flag
} infoUpdatePacket;

// USB update packet struct
// includes header and footer, as well as the new flag
struct USBUpdatePacket {
	uint8_t packetHeader;			// packet type; typically FLAG_UPDATE_START
	uint8_t newData;				// indicated if the data in the packet is new (different timestamp)
	struct updatePacket data;		// update packet struct containing update data
	uint8_t packetFooter;			// packet footer; typically FLAG_UPDATE_END
} currUSBUpdatePacket;

// Config struct:
//
// relay coil voltage setting (4 bytes),
// test frequency (4 bytes),
// number of cycles (4 bytes),
// length of test (timestamp):
//	   timestamp (4 bytes)
// bounce test period (in cycles) (2 bytes),
// coil current test period (in cycles) (2 bytes),
// coil resistance test period (in cycles) (2 bytes),
// number of failures before stop (1 byte)
// Total: 36 bytes
struct configPacket {
	float coilV;				// coil voltage (0.0 means test for it)
	float testPeriod;				// test period (ms)
	uint32_t numCycles;			// number of cycles in test
	struct timestamp end_t;		// end time timestamp
	uint16_t bounceTestPer;		// bounce test period
	uint16_t coilCurrentTestPer;// coil current test period
	uint16_t coilResistTestPer; // coil resistance test period
	uint16_t numFail;			// number of failures before test is auto stopped
} testParams;	// create struct to hold test parameters

// USB config packet struct
// includes header and footer
struct USBConfigPacket {
	uint8_t packetHeader;			// packet type; typically FLAG_CONFIG_START
	struct configPacket data;		// update packet struct containing config data
	uint8_t packetFooter;			// packet footer; typically FLAG_CONFIG_END
} newTestParamsPacket;

// USB buffer for lower-level xStreamBuffer
uint8_t usbBuffer[512];

/* USER CODE END PV */

void SystemClock_Config(void);
static void MX_GPIO_Init(void);
static void MX_DMA_Init(void);
static void MX_ADC1_Init(void);
static void MX_ADC2_Init(void);
static void MX_DAC_Init(void);
static void MX_I2C1_Init(void);
static void MX_SPI2_Init(void);
static void MX_USART3_UART_Init(void);
static void MX_RTC_Init(void);
static void MX_USB_OTG_FS_PCD_Init(void);
static void MX_TIM6_Init(void);
void StartDefaultTask(void *argument);
void StartProcessUSB(void *argument);

/* USER CODE BEGIN PFP */
void DMATransferComplete(DMA_HandleTypeDef *hdma);

/* USER CODE END PFP */

/* USER CODE BEGIN 0 */

/**
 * @brief This function handles EXTI line4 interrupt.
 */
void EXTI4_IRQHandler(void) {
	/* USER CODE BEGIN EXTI4_IRQn 0 */

	HAL_TIM_Base_Stop(&htim6);			// stop timer
	switchTime = htim6.Instance->CNT;	// record counter value
	triggered = 1;

	/* USER CODE END EXTI4_IRQn 0 */
	HAL_GPIO_EXTI_IRQHandler(GPIO_PIN_4);
}

/* USER CODE END 0 */

/**
 * @brief  The application entry point.
 * @retval int
 */
int main(void) {
	/* MCU Configuration--------------------------------------------------------*/

	/* Reset of all peripherals, Initializes the Flash interface and the Systick. */
	HAL_Init();

	/* Configure the system clock */
	SystemClock_Config();

	/* Initialize all configured peripherals */
	MX_GPIO_Init();
	MX_DMA_Init();
	MX_ADC1_Init();
	MX_ADC2_Init();
	MX_DAC_Init();
	MX_I2C1_Init();
	MX_SPI2_Init();
	MX_USART3_UART_Init();
	MX_RTC_Init();
	MX_USB_OTG_FS_PCD_Init();
	MX_TIM6_Init();

	/* USER CODE BEGIN 2 */

	HAL_GPIO_WritePin(PS_EN_GPIO_Port, PS_EN_Pin, GPIO_PIN_RESET);	// disable power supply

	USBD_Init(&hUsbDeviceFS, &Class_Desc, 0);
	USBD_RegisterClass(&hUsbDeviceFS, &USBD_TEMPLATE_ClassDriver);
	USBD_Start(&hUsbDeviceFS);

	// I2C to INA226
	// set configuration
	uint16_t INAconfig = (0x4000 | INA226_AVG_64 | INA226_VBUS_2116uS
			| INA226_VSH_2116uS | INA226_MODE_CONT);
	i2cBuf[0] = 0x00;
	i2cBuf[1] = INAconfig >> 8;
	i2cBuf[2] = INAconfig;
	HAL_I2C_Master_Transmit(&hi2c1, INA226_ADDRESS_WRITE, i2cBuf, 3,
	INA226_I2C_TO);

	// set calibration
	i2cBuf[0] = 0x05;
	i2cBuf[1] = 0x11;
	i2cBuf[2] = 0x7A;
	HAL_I2C_Master_Transmit(&hi2c1, INA226_ADDRESS_WRITE, i2cBuf, 3,
	INA226_I2C_TO);

	uint16_t spiBuf[1];
	spiBuf[0] = 0b0100000000000101;
	HAL_SPI_Transmit(&hspi2, &spiBuf, 1, 50);	// set gain to 8

	//HAL_SPI_Transmit(&hspi2, uint8_t * pData, uint16_t Size, uint32_t Timeout)

//	HAL_SPI_Transmit(&hspi2, (uint8_t*)&buf, 1, 100);

	// MCP6S2x
	//configure bounce gain to 10x
//	setGain(10);

	// DAC init
	HAL_DAC_Start(&hdac, DAC_CHANNEL_2);
	HAL_DAC_SetValue(&hdac, DAC_CHANNEL_2, DAC_ALIGN_12B_R, 4096);    // 0V

	// RTC
//	setTime();

	// default
	testParams.testPeriod = 1000;

	/*****For USB****
	 * HAL_DMA_RegisterCallback(&hdma_usart3_tx, HAL_DMA_XFER_CPLT_CB_ID, &DMATransferComplete);
	 */
	//Start ADC with DMA transfer
	//HAL_ADC_Start_DMA(&hadc1, (uint32_t*)adc_buf, ADC_BUF_LEN);
	/* USER CODE END 2 */

	/* Init scheduler */
	osKernelInitialize();

	/* USER CODE BEGIN RTOS_MUTEX */
	/* add mutexes, ... */
	/* USER CODE END RTOS_MUTEX */

	/* USER CODE BEGIN RTOS_SEMAPHORES */
	/* add semaphores, ... */
	/* USER CODE END RTOS_SEMAPHORES */

	/* USER CODE BEGIN RTOS_TIMERS */
	/* start timers, add new ones, ... */
	/* USER CODE END RTOS_TIMERS */

	/* USER CODE BEGIN RTOS_QUEUES */
	xStreamBuffer = xStreamBufferCreate(512, 1);
	/* USER CODE END RTOS_QUEUES */

	/* Create the thread(s) */
	/* creation of defaultTask */
	const osThreadAttr_t defaultTask_attributes = {
			.name = "defaultTask",
			.priority = (osPriority_t) osPriorityNormal,
			.stack_size = 256
	};
	defaultTaskHandle = osThreadNew(StartDefaultTask, NULL,
			&defaultTask_attributes);

	/* definition and creation of invertAsciiTask */
	const osThreadAttr_t processUSB_attributes = {
			.name =	"processUSBTask",
			.priority = (osPriority_t) osPriorityHigh,
			.stack_size = 768
	};
	processUSBTaskHandle = osThreadNew(StartProcessUSB, NULL,
			&processUSB_attributes);

	/* USER CODE BEGIN RTOS_THREADS */
	/* add threads, ... */
	/* USER CODE END RTOS_THREADS */

	/* USER CODE BEGIN RTOS_EVENTS */
	/* add events, ... */
	/* USER CODE END RTOS_EVENTS */

	/* Start scheduler */
	osKernelStart();

	/* We should never get here as control is now taken by the scheduler */
	/* Infinite loop */
	/* USER CODE BEGIN WHILE */
	while (1) {

		// DO NOT PUT ANYTHING IN HERE
		// ALL LOOPED CODE SHOULD GO IN DEFAULT TASK FUNCTION

		/* USER CODE END WHILE */

		/* USER CODE BEGIN 3 */

		// NO!!! (╯°□°)╯︵ ┻━┻
	}
	/* USER CODE END 3 */
}

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
/* USER CODE BEGIN 4 */
//For USB
void DMATransferComplete(DMA_HandleTypeDef *hdma) {
	//Disable UART DMA mode
//	huart3.Instance->CR3 &= ~USART_CR3_DMAT;
}

/*//Called when first half of buffer is filled, turns on LED
 void HAL_ADC_ConvHalfCpltCallback(ADC_HandleTypeDef* hadc){
 HAL_GPIO_WritePin(LD2_GPIO_Port, LD2_Pin, GPIO_PIN_SET);
 }

 //Called when buffer it totally full, turns off LED
 void HAL_ADC_ConvCpltCallback(ADC_HandleTypeDef* hadc){
 HAL_GPIO_WritePin(LD2_GPIO_Port, LD2_Pin, GPIO_PIN_RESET);
 }*/

//function for data packets for USART
//packets will have a 2 bit start/end opcode, 2 bit opcode for what type of data (bounce info, coil resistance, etc) and the data
//need defines for data types
//void USART_Packet(uint8_t dType, uint32_t msg) {
//
//}


// compare two timestamps
// returns:
//		-1: time1 is OLDER than time2
//		0: time1 is the same as time2
//		1: time1 is NEWER than time2
//int compareTime(struct timestamp *time1, struct timestamp *time2) {
//
//	if (time1->hours > time2->hours) {
//		return 1;
//	} else if (time1->hours < time2->hours) {
//		return -1;
//	} else {
//		if (time1->mins > time2->mins) {
//			return 1;
//		} else if (time1->mins < time2->mins) {
//			return -1;
//		} else {
//			if (time1->secs > time2->secs) {
//				return 1;
//			} else if (time1->secs < time2->secs) {
//				return -1;
//			} else {
//				if (time1->msecs > time2->msecs) {
//					return 1;
//				} else if (time1->msecs < time2->msecs) {
//					return -1;
//				} else {
//					return 0;
//				}
//			}
//		}
//	}
//}

//Set RTC time
//void setTime(void) {
//	RTC_TimeTypeDef sTime;
//	RTC_DateTypeDef sDate;
//	/*set time*/
//	sTime.Hours = 0x00;			//set hours
//	sTime.Minutes = 0x00;		//set minutes
//	sTime.Seconds = 0x00;		//set seconds
//	sTime.SubSeconds = 0x00;	//set sub seconds
//	sTime.DayLightSaving = RTC_DAYLIGHTSAVING_NONE;
//	sTime.StoreOperation = RTC_STOREOPERATION_RESET;
//	if (HAL_RTC_SetTime(&hrtc, &sTime, RTC_FORMAT_BCD) != HAL_OK)
//		Error_Handler();
//
//	/*set date*/
//	sDate.Date = 0x00;					//date
//	sDate.Month = RTC_MONTH_JANUARY;//month (how to set this to current month??)
//	if (HAL_RTC_SetDate(&hrtc, &sDate, RTC_FORMAT_BCD) != HAL_OK)
//		Error_Handler();
//
//	//assign backup register to maintain time after system reset
////	HAL_RTCEx_BKUPWrite(&hrtc, RTC_BKP_DR1, 0x32f2);
//}

//get RTC time
//void getTime(struct timestamp *times) {
//	RTC_TimeTypeDef gTime;
//	RTC_DateTypeDef gDate;
//	//get current time
//	HAL_RTC_GetTime(&hrtc, &gTime, RTC_FORMAT_BIN);
//	//get current date
//	HAL_RTC_GetDate(&hrtc, &gDate, RTC_FORMAT_BIN);
//	//display time
////	sprintf((char*) time, "%02d:%02d:%02d:%02d", gTime.Hours, gTime.Minutes,
////			gTime.Seconds, gTime.SubSeconds);
////	//display date
////	sprintf((char*) date, "%02d %02d", gDate.Month, gDate.Date);
//
//
//	// put into struct
//	times->hours = gTime.Hours + (gDate.Date * 24);
//	times->mins = gTime.Minutes;
//	times->secs = gTime.Seconds;
//	times->msecs = gTime.SubSeconds;
//}
//
//struct timestamp actTimeStart;

// computer time difference between two timestamps
//void computeTimeDiff(struct timestamp *diffTime, struct timestamp *time1, struct timestamp *time2) {
//	diffTime->hours = time1->hours - time2->hours;
//	diffTime->mins = time1->mins - time2->mins;
//	diffTime->secs = time1->secs - time2->secs;
//	diffTime->msecs = time1->msecs - time2->msecs;
//}


// pack data into packet data format
void packUpdate() {

	//get RTC time
//	prevTime = currTime;
//	getTime(&currTime);
//	computeTimeDiff(&diffTime, &currTime, &startTime);

//	char timeStr[24];
//	sprintf(timeStr, "%d:%d:%d:%d\n", diffTime.hours, diffTime.mins, diffTime.secs, diffTime.msecs);
//	HAL_UART_Transmit(&huart3, timeStr, 24, 100);

	currUSBUpdatePacket.packetHeader = FLAG_UPDATE_START; // update start flag

	currUSBUpdatePacket.packetHeader = FLAG_UPDATE_START; // update start flag

	// INA226 data

	// bus voltage
	infoUpdatePacket.busV = i2cresults[0];

	// shunt voltage
	infoUpdatePacket.shuntV = i2cresults[1];

	// bus current
	infoUpdatePacket.busI = i2cresults[2];

	// bus power
	infoUpdatePacket.busP = i2cresults[3];

	// current cycle
	infoUpdatePacket.cycle = cyclesElapsed;

	// bounce data ready flag
	infoUpdatePacket.bounceReady = bounceDataReady;
	bounceDataReady = 0;

	currUSBUpdatePacket.data = infoUpdatePacket;
//	infoUpdatePacket.ts = diffTime;
//	infoUpdatePacket.ts.hours = (uint16_t)((uint32_t)(cyclesElapsed+1) * (uint32_t)testParams.testPeriod) / 3600000;
//	infoUpdatePacket.ts.mins = (uint16_t)((uint32_t)(cyclesElapsed+1) * (uint32_t)testParams.testPeriod) / 60000;
//	infoUpdatePacket.ts.secs = (uint16_t)((uint32_t)(cyclesElapsed+1) * (uint32_t)testParams.testPeriod) / 1000;
//	infoUpdatePacket.ts.msecs = 1;

	currUSBUpdatePacket.packetFooter = FLAG_UPDATE_END; // update end flag

	// update new data flag
//	if (compareTime(&currTime, &prevTime) > 0) {
//		currUSBUpdatePacket.newData = FLAG_UPDATE_NEW;
//	} else {
//		currUSBUpdatePacket.newData = FLAG_UPDATE_OLD;
//	}
	if (cyclesElapsed != prevCycle) {
		currUSBUpdatePacket.newData = FLAG_UPDATE_NEW;
	} else {
		currUSBUpdatePacket.newData = FLAG_UPDATE_OLD;
	}
}

uint8_t nextState() {

}
/* USER CODE END 4 */

/* USER CODE BEGIN Header_StartDefaultTask */
/**
 * @brief  Function implementing the defaultTask thread.
 * @param  argument: Not used
 * @retval None
 */
/* USER CODE END Header_StartDefaultTask */
void StartDefaultTask(void *argument) {
	/* USER CODE BEGIN 5 */
	/* Infinite loop */
	for (;;) {

		if (running) {
			osDelay((newTestParamsPacket.data.testPeriod*0.25) - 50);

			if (bounceTimer == 0 && bounceTest == 1) {
				HAL_ADC_Start_DMA(&hadc1, (uint32_t*)adc_buf, ADC_BUF_LEN);				// start ADC1
				osDelay(2);
				for (uint16_t i = 0; i < 2500; i++) {

				}
			}

			// activation time test
			htim6.Instance->CNT = TIMER_MIN;										// reset time value to min
			HAL_GPIO_WritePin(TRIG_OUT_GPIO_Port, TRIG_OUT_Pin, GPIO_PIN_SET);		// trigger pin HIGH
			HAL_TIM_Base_Start(&htim6);

			while (triggered == 0) {		// wait for trigger
				osDelay(1);
			}

			infoUpdatePacket.act_t = (uint32_t)switchTime;							// record switch time

			if (bounceTimer == 0 && bounceTest == 1) {
				osDelay(3);
				HAL_ADC_Stop_DMA(&hadc1);				// stop ADC1
				bounceDataReady = 2;					// set flag
				bounceTimer = testParams.bounceTestPer;	// reset bounce timer
			} else {
				bounceTimer--;
			}

			triggered = 0;		// reset

			osDelay(newTestParamsPacket.data.testPeriod*0.75);

			// get Bus Voltage
			i2cBuf[0] = 0x02;
			HAL_I2C_Master_Transmit(&hi2c1, INA226_ADDRESS_READ, i2cBuf, 3,
			INA226_I2C_TO);
			HAL_I2C_Master_Receive(&hi2c1, INA226_ADDRESS_READ, &i2cBuf[1], 2,
			INA226_I2C_TO);

			i2cresults[0] = (uint16_t) i2cBuf[1] << 8 | i2cBuf[2];

			// get shunt Voltage
			i2cBuf[0] = 0x01;
			HAL_I2C_Master_Transmit(&hi2c1, INA226_ADDRESS_READ, i2cBuf, 3,
			INA226_I2C_TO);
			HAL_I2C_Master_Receive(&hi2c1, INA226_ADDRESS_READ, &i2cBuf[1], 2,
			INA226_I2C_TO);

			i2cresults[1] = (uint16_t) i2cBuf[1] << 8 | i2cBuf[2];

			// get Bus Power
			i2cBuf[0] = 0x03;
			HAL_I2C_Master_Transmit(&hi2c1, INA226_ADDRESS_READ, i2cBuf, 3,
			INA226_I2C_TO);
			HAL_I2C_Master_Receive(&hi2c1, INA226_ADDRESS_READ, &i2cBuf[1], 2,
			INA226_I2C_TO);

			i2cresults[3] = (uint16_t) i2cBuf[1] << 8 | i2cBuf[2];

			// get Bus Current
			i2cBuf[0] = 0x04;
			HAL_I2C_Master_Transmit(&hi2c1, INA226_ADDRESS_READ, i2cBuf, 3,
			INA226_I2C_TO);
			HAL_I2C_Master_Receive(&hi2c1, INA226_ADDRESS_READ, &i2cBuf[1], 2,
			INA226_I2C_TO);

			i2cresults[2] = (uint16_t) i2cBuf[1] << 8 | i2cBuf[2];

			// deactivation time test
			htim6.Instance->CNT = TIMER_MIN;										// reset time value to min
			HAL_GPIO_WritePin(TRIG_OUT_GPIO_Port, TRIG_OUT_Pin, GPIO_PIN_RESET);	// trigger pin LOW
			HAL_TIM_Base_Start(&htim6);

			while (triggered == 0) {		// wait for trigger
			}

			infoUpdatePacket.deact_t = (uint32_t)switchTime;
			triggered = 0;		// reset

			if (currentTimer == 0 && currentTest == 1) {
//				HAL_UART_Transmit(&huart3, "CURRENT TEST!\n", 13, USART_TIMEOUT);
				currentTimer = testParams.coilCurrentTestPer;
			} else {
				currentTimer--;
			}

			if (resistTimer == 0 && resistTest == 1) {
//				HAL_UART_Transmit(&huart3, "RESIST TEST!\n", 13, USART_TIMEOUT);
				resistTimer = testParams.coilResistTestPer;
			} else {
				resistTimer--;
			}

			prevCycle = cyclesElapsed;		// save previous cycle number
			cyclesElapsed++;				// increment cycles count

			if (cyclesElapsed < 10) {
//				HAL_DAC_SetValue(&hdac, DAC_CHANNEL_2, DAC_ALIGN_12B_R, 3100);	// 5V
				HAL_DAC_SetValue(&hdac, DAC_CHANNEL_2, DAC_ALIGN_12B_R, 835);    // 12V
			} else if (cyclesElapsed >= 10 && cyclesElapsed < 20) {
//				HAL_DAC_SetValue(&hdac, DAC_CHANNEL_2, DAC_ALIGN_12B_R, 3120);	// 5V
				HAL_DAC_SetValue(&hdac, DAC_CHANNEL_2, DAC_ALIGN_12B_R, 855);    // 12V
			} else if (cyclesElapsed >= 20 && cyclesElapsed < 30) {
//				HAL_DAC_SetValue(&hdac, DAC_CHANNEL_2, DAC_ALIGN_12B_R, 3140);	// 5V
				HAL_DAC_SetValue(&hdac, DAC_CHANNEL_2, DAC_ALIGN_12B_R, 875);    // 12V
			} else if (cyclesElapsed >= 30 && cyclesElapsed < 40) {
//				HAL_DAC_SetValue(&hdac, DAC_CHANNEL_2, DAC_ALIGN_12B_R, 3150);	// 5V
				HAL_DAC_SetValue(&hdac, DAC_CHANNEL_2, DAC_ALIGN_12B_R, 900);    // 12V
			}

		} else {
			osDelay(500);

			// get Bus Voltage
			i2cBuf[0] = 0x02;
			HAL_I2C_Master_Transmit(&hi2c1, INA226_ADDRESS_READ, i2cBuf, 3,
			INA226_I2C_TO);
			HAL_I2C_Master_Receive(&hi2c1, INA226_ADDRESS_READ, &i2cBuf[1], 2,
			INA226_I2C_TO);

			i2cresults[0] = (uint16_t) i2cBuf[1] << 8 | i2cBuf[2];

			// get shunt Voltage
			i2cBuf[0] = 0x01;
			HAL_I2C_Master_Transmit(&hi2c1, INA226_ADDRESS_READ, i2cBuf, 3,
			INA226_I2C_TO);
			HAL_I2C_Master_Receive(&hi2c1, INA226_ADDRESS_READ, &i2cBuf[1], 2,
			INA226_I2C_TO);

			i2cresults[1] = (uint16_t) i2cBuf[1] << 8 | i2cBuf[2];

			// get Bus Power
			i2cBuf[0] = 0x03;
			HAL_I2C_Master_Transmit(&hi2c1, INA226_ADDRESS_READ, i2cBuf, 3,
			INA226_I2C_TO);
			HAL_I2C_Master_Receive(&hi2c1, INA226_ADDRESS_READ, &i2cBuf[1], 2,
			INA226_I2C_TO);

			i2cresults[3] = (uint16_t) i2cBuf[1] << 8 | i2cBuf[2];

			// get Bus Current
			i2cBuf[0] = 0x04;
			HAL_I2C_Master_Transmit(&hi2c1, INA226_ADDRESS_READ, i2cBuf, 3,
			INA226_I2C_TO);
			HAL_I2C_Master_Receive(&hi2c1, INA226_ADDRESS_READ, &i2cBuf[1], 2,
			INA226_I2C_TO);

			i2cresults[2] = (uint16_t) i2cBuf[1] << 8 | i2cBuf[2];
		}

		HAL_GPIO_TogglePin(LD1_GPIO_Port, LD1_Pin);	// flash green LED

		// Update the USB packet with latest data
		packUpdate();
	}
}

		//reading from ADC1 with DMA (for USart/USB)
		//huart3.Instance->CR3 |= USART_CR3_DMAT;

		/****For USB*****
		 HAL_DMA_Start_IT(&hdma_usart3_tx, msg,(uint32_t)&huart3.Instance->TDR, strlen(msg));
		 */

		//get ADC2 Value
		//HAL_ADC_Start(&hadc2);
		//HAL_ADC_PollForConversion(&hadc2, HAL_MAX_DELAY);
		//reading = HAL_ADC_GetValue(&hadc2);


/* USER CODE BEGIN Header_StartProcessUSB */
/**
 * @brief Function implementing the processUSB thread.
 * @param argument: Not used
 * @retval None
 */
/* USER CODE END Header_StartProcessUSB */
void StartProcessUSB(void *argument) {
	/* USER CODE BEGIN StartInvertAsciiTask */
	uint8_t sendResponse = 0;

	/* Infinite loop */
	for (;;) {
		size_t count = xStreamBufferReceive(xStreamBuffer, usbBuffer, 512, 2);
		if (!count)
			continue;

		// parse incoming command from PC
		if (count == 4) {
			switch (usbBuffer[0]) {

			case CMD_START:
				//HAL_UART_Transmit(&huart3, "Start command\n", 14, USART_TIMEOUT);

				HAL_GPIO_TogglePin(LD3_GPIO_Port, LD3_Pin);	// flash red LED
//				getTime(&startTime);
//				diffTime.hours = 0;
//				diffTime.mins = 0;
//				diffTime.secs = 0;
//				diffTime.msecs = 0;

				cyclesElapsed = 0;

				HAL_GPIO_WritePin(PS_EN_GPIO_Port, PS_EN_Pin, GPIO_PIN_SET);	// enable power supply
//				HAL_DAC_SetValue(&hdac, DAC_CHANNEL_2, DAC_ALIGN_12B_R, 3100);    // 5.5V
				HAL_DAC_SetValue(&hdac, DAC_CHANNEL_2, DAC_ALIGN_12B_R, 860);    // 12.25V

//				osDelay(20);

				running = 1;
				break;

			case CMD_STOP:
				//HAL_UART_Transmit(&huart3, "Stop command\n", 13, USART_TIMEOUT);

				HAL_GPIO_TogglePin(LD3_GPIO_Port, LD3_Pin);	// flash red LED

				running = 0;
				break;

			case CMD_GET_UPDATE:
				HAL_GPIO_TogglePin(LD2_GPIO_Port, LD2_Pin);	// flash Blue LED
				//HAL_UART_Transmit(&huart3, "Get update command\n", 18, USART_TIMEOUT);

				count = USB_UPDATE_LEN;

				memcpy(&usbBuffer, &currUSBUpdatePacket, USB_UPDATE_LEN); // copy new packet data to buffer

				HAL_GPIO_TogglePin(LD2_GPIO_Port, LD2_Pin);	// flash Blue LED

				sendResponse = 1;

				break;

			case CMD_GET_BOUNCE_DATA:
				HAL_GPIO_TogglePin(LD2_GPIO_Port, LD2_Pin);	// flash Blue LED
//				HAL_UART_Transmit(&huart3, "Get bounce command\n", 19, USART_TIMEOUT);

				uint8_t bounceIndex = usbBuffer[1];

				count = 500;

//				memcpy(&usbBuffer, (uint8_t)&adc_buf, 500);

				// get data from ADC buffer
				for (uint16_t k = 0; k < 500; k++) {
					usbBuffer[k] = (uint8_t)adc_buf[k+3500+((bounceIndex-1)*500)];		// + 0 for 5V, +3000 for 12V
				}

				uint8_t status = USBD_TEMPLATE_Transmit(&hUsbDeviceFS, usbBuffer, count);
				while (status != USBD_OK){

				}
				osDelay(2);

				memcpy(&usbBuffer, &currUSBUpdatePacket, 36); // copy new packet data to buffer

				HAL_GPIO_TogglePin(LD2_GPIO_Port, LD2_Pin);	// flash Blue LED

				sendResponse = 0;

				break;

			case CMD_CHECK_CONN:
				usbBuffer[3] = STM32_OK;
				//HAL_UART_Transmit(&huart3, "Connection check\n", 17, USART_TIMEOUT);
				sendResponse = 1;
				break;

			default:
				usbBuffer[3] = STM32_UNKNOWN;
				//HAL_UART_Transmit(&huart3, "Unknown command!\n", 17, USART_TIMEOUT);
				sendResponse = 1;
				break;
			}
		} else if (count == USB_CONFIG_LEN) {
			if (usbBuffer[0] == CMD_SET_CONFIG) {

				if (usbBuffer[1] == FLAG_CONFIG_START && usbBuffer[USB_CONFIG_LEN - 1] == FLAG_CONFIG_END) {
					//HAL_UART_Transmit(&huart3, "Config received\n", 16, USART_TIMEOUT);

					HAL_GPIO_TogglePin(LD3_GPIO_Port, LD3_Pin);	// flash red LED twice
					osDelay(400);
					HAL_GPIO_TogglePin(LD3_GPIO_Port, LD3_Pin);	// flash red LED twice
					osDelay(200);
					HAL_GPIO_TogglePin(LD3_GPIO_Port, LD3_Pin);	// flash red LED twice
					osDelay(400);
					HAL_GPIO_TogglePin(LD3_GPIO_Port, LD3_Pin);	// flash red LED twice

					memcpy(&newTestParamsPacket, usbBuffer+1, 33);

//					if (testParams.testPeriod != newTestParamsPacket.data.testPeriod) {
//						HAL_UART_Transmit(&huart3, "New test period\n", 16, USART_TIMEOUT);
//					}

					testParams.testPeriod = newTestParamsPacket.data.testPeriod;
					testParams.numCycles = newTestParamsPacket.data.numCycles;
					testParams.end_t = newTestParamsPacket.data.end_t;
					testParams.coilV = newTestParamsPacket.data.coilV;
					testParams.bounceTestPer = newTestParamsPacket.data.bounceTestPer;
					testParams.coilCurrentTestPer = newTestParamsPacket.data.coilCurrentTestPer;
					testParams.coilResistTestPer = newTestParamsPacket.data.coilResistTestPer;
					testParams.numFail = newTestParamsPacket.data.numFail;

					if (testParams.bounceTestPer > 1) {
						bounceTest = 1;
						bounceTimer = testParams.bounceTestPer;
					}
					if (testParams.coilCurrentTestPer > 1) {
						currentTest = 1;
						currentTimer = testParams.coilCurrentTestPer;
					}
					if (testParams.coilResistTestPer > 1) {
						resistTest = 1;
						resistTimer = testParams.coilResistTestPer;
					}

				}
			}
		}

		if (sendResponse == 1) {
			for (;;) {
				uint8_t status = USBD_TEMPLATE_Transmit(&hUsbDeviceFS, usbBuffer,
						count);
				if (status == USBD_OK)
					break;
				osDelay(1);
			}
		}
	}
	/* USER CODE END StartProcessUSB */
}

/**
 * @brief  Period elapsed callback in non blocking mode
 * @note   This function is called  when TIM14 interrupt took place, inside
 * HAL_TIM_IRQHandler(). It makes a direct call to HAL_IncTick() to increment
 * a global variable "uwTick" used as application time base.
 * @param  htim : TIM handle
 * @retval None
 */
void HAL_TIM_PeriodElapsedCallback(TIM_HandleTypeDef *htim) {
	if (htim->Instance == TIM14) {
		HAL_IncTick();
	}
}

/**
 * @brief  This function is executed in case of error occurrence.
 * @retval None
 */
void Error_Handler(void) {
	/* USER CODE BEGIN Error_Handler_Debug */
	/* User can add his own implementation to report the HAL error return state */

	/* USER CODE END Error_Handler_Debug */
}

#ifdef  USE_FULL_ASSERT
/**
  * @brief  Reports the name of the source file and the source line number
  *         where the assert_param error has occurred.
  * @param  file: pointer to the source file name
  * @param  line: assert_param error line source number
  * @retval None
  */
void assert_failed(uint8_t *file, uint32_t line)
{
  /* USER CODE BEGIN 6 */
  /* User can add his own implementation to report the file name and line number,
     tex: printf("Wrong parameters value: file %s on line %d\r\n", file, line) */
  /* USER CODE END 6 */
}
#endif /* USE_FULL_ASSERT */

/************************ (C) COPYRIGHT STMicroelectronics *****END OF FILE****/
