Hengy/RelayAnalyzerHardware/Firmware/Relay_Analyzer/Relay_Analyzer.ioc

PB14.GPIO_Label=LD3 [Red]
PG6.GPIO_Label=USB_PowerSwitchOn [STMPS2151STR_EN]
PA14.GPIO_Label=TCK
PB13.Signal=ETH_TXD1
PG13.Signal=ETH_TXD0
PD4.Signal=GPIO_Output
PB6.Signal=I2C1_SCL
PH1/OSC_OUT.Signal=RCC_OSC_OUT
PC3.Signal=SPI2_MOSI
PD0.Signal=GPIO_Output
PD8.Signal=USART3_TX
PC4.GPIO_Label=RMII_RXD0 [LAN8742A-CZ-TR_RXD0]
PA8.Signal=USB_OTG_FS_SOF
PE10.Signal=GPIO_Output
PB9.Signal=I2C1_SDA
PA10.Signal=USB_OTG_FS_ID
PD9.GPIO_Label=STLK_TX [STM32F103CBT6_PA2]
PC13.Signal=GPXTI13
PA9.GPIO_Label=USB_VBUS
PD3.Signal=GPIO_Output
PD1.Signal=GPIO_Output
PA11.GPIO_Label=USB_DM
PG13.GPIO_Label=RMII_TXD0 [LAN8742A-CZ-TR_TXD0]
PA8.GPIO_Label=USB_SOF [TP1]
PA9.Signal=USB_OTG_FS_VBUS
PB10.Signal=SPI2_SCK
PB14.Signal=GPIO_Output
PA5.Signal=COMP_DAC2_group
PE14.Signal=GPIO_Output
PE15.Signal=GPIO_Output
PG7.GPIO_Label=USB_OverCurrent [STMPS2151STR_FAULT]
PA1.GPIO_Label=RMII_REF_CLK [LAN8742A-CZ-TR_REFCLK0]
PA4.Signal=COMP_DAC1_group
PA11.Signal=USB_OTG_FS_DM
PC15/OSC32_OUT.Signal=RCC_OSC32_OUT
PD2.Signal=GPIO_Output
PB0.Signal=GPIO_Output
PC1.Signal=ETH_MDC
PG6.Signal=GPIO_Output
Mcu.UserName=STM32F767ZITx
PA0/WKUP.Signal=ADCx_IN0
PB0.GPIO_Label=LD1 [Green]
PC13.GPIO_Label=USER_Btn [B1]
PB13.GPIO_Label=RMII_TXD1 [LAN8742A-CZ-TR_TXD1]
PG11.Signal=ETH_TX_EN
PA12.Signal=USB_OTG_FS_DP
PE13.Signal=GPIO_Output
PA10.GPIO_Label=USB_ID
PB7.Signal=GPIO_Output
PB7.GPIO_Label=LD2 [Blue]
PC14/OSC32_IN.Signal=RCC_OSC32_IN
PA2.GPIO_Label=RMII_MDIO [LAN8742A-CZ-TR_MDIO]
PG11.GPIO_Label=RMII_TX_EN [LAN8742A-CZ-TR_TXEN]
PC5.Signal=ETH_RXD1
PA3.Signal=ADCx_IN3
PB3.GPIO_Label=SWO
PG7.Signal=GPIO_Input
PC4.Signal=ETH_RXD0
PD9.Signal=USART3_RX
PD5.Signal=GPIO_Output
PA12.GPIO_Label=USB_DP
PD8.GPIO_Label=STLK_RX [STM32F103CBT6_PA3]
PA13.Signal=SYS_JTMS-SWDIO
PE11.Signal=GPIO_Output
PA1.Signal=ETH_REF_CLK
PH0/OSC_IN.Signal=RCC_OSC_IN
PC1.GPIO_Label=RMII_MDC [LAN8742A-CZ-TR_MDC]
PE12.Signal=GPIO_Output
PA2.Signal=ETH_MDIO
PA13.GPIO_Label=TMS
PB3.Signal=SYS_JTDO-SWO
PA7.GPIO_Label=RMII_CRS_DV [LAN8742A-CZ-TR_CRS_DV]
PC5.GPIO_Label=RMII_RXD1 [LAN8742A-CZ-TR_RXD1]
PA14.Signal=SYS_JTCK-SWCLK
PH0/OSC_IN.GPIO_Label=MCO [STM32F103CBT6_PA8]
PB12.Signal=SPI2_NSS
PA7.Signal=ETH_CRS_DV
