Hengy/RelayAnalyzerHardware/Firmware/Relay_Analyzer/Core/Inc/main.h

#define USER_Btn_Pin GPIO_PIN_13
#define USER_Btn_GPIO_Port GPIOC
#define MCO_Pin GPIO_PIN_0
#define MCO_GPIO_Port GPIOH
#define RMII_MDC_Pin GPIO_PIN_1
#define RMII_MDC_GPIO_Port GPIOC
#define RMII_REF_CLK_Pin GPIO_PIN_1
#define RMII_REF_CLK_GPIO_Port GPIOA
#define RMII_MDIO_Pin GPIO_PIN_2
#define RMII_MDIO_GPIO_Port GPIOA
#define RMII_CRS_DV_Pin GPIO_PIN_7
#define RMII_CRS_DV_GPIO_Port GPIOA
#define RMII_RXD0_Pin GPIO_PIN_4
#define RMII_RXD0_GPIO_Port GPIOC
#define RMII_RXD1_Pin GPIO_PIN_5
#define RMII_RXD1_GPIO_Port GPIOC
#define LD1_Pin GPIO_PIN_0
#define LD1_GPIO_Port GPIOB
#define RMII_TXD1_Pin GPIO_PIN_13
#define RMII_TXD1_GPIO_Port GPIOB
#define LD3_Pin GPIO_PIN_14
#define LD3_GPIO_Port GPIOB
#define STLK_RX_Pin GPIO_PIN_8
#define STLK_RX_GPIO_Port GPIOD
#define STLK_TX_Pin GPIO_PIN_9
#define STLK_TX_GPIO_Port GPIOD
#define USB_PowerSwitchOn_Pin GPIO_PIN_6
#define USB_PowerSwitchOn_GPIO_Port GPIOG
#define USB_OverCurrent_Pin GPIO_PIN_7
#define USB_OverCurrent_GPIO_Port GPIOG
#define USB_SOF_Pin GPIO_PIN_8
#define USB_SOF_GPIO_Port GPIOA
#define USB_VBUS_Pin GPIO_PIN_9
#define USB_VBUS_GPIO_Port GPIOA
#define USB_ID_Pin GPIO_PIN_10
#define USB_ID_GPIO_Port GPIOA
#define USB_DM_Pin GPIO_PIN_11
#define USB_DM_GPIO_Port GPIOA
#define USB_DP_Pin GPIO_PIN_12
#define USB_DP_GPIO_Port GPIOA
#define TMS_Pin GPIO_PIN_13
#define TMS_GPIO_Port GPIOA
#define TCK_Pin GPIO_PIN_14
#define TCK_GPIO_Port GPIOA
#define RMII_TX_EN_Pin GPIO_PIN_11
#define RMII_TX_EN_GPIO_Port GPIOG
#define RMII_TXD0_Pin GPIO_PIN_13
#define RMII_TXD0_GPIO_Port GPIOG
#define SWO_Pin GPIO_PIN_3
#define SWO_GPIO_Port GPIOB
#define LD2_Pin GPIO_PIN_7
#define LD2_GPIO_Port GPIOB
#define PS_EN_Pin GPIO_PIN_10
#define PS_EN_GPIO_Port GPIOC
#define TRIG_OUT_Pin GPIO_PIN_3
#define TRIG_OUT_GPIO_Port GPIOG
#define TRIG_IN_Pin GPIO_PIN_4
#define TRIG_IN_GPIO_Port GPIOE
#define ADC_BUF_LEN 10000
#define USB_TIMEOUT             20   // timeout in ms
#define USB_TIMEOUT_SHORT       5   // short timeout in ms
#define USB_TIMEOUT_LONG        100  // long timeout in ms
#define USART_TIMEOUT			500 // timeout in ms
#define STM32_OK		0xAA
#define STM32_NOT_OK	0xBB
#define STM32_UNKNOWN	0xE0
#define FLAG_UPDATE_START	0xC0
#define FLAG_UPDATE_END		0xCF
#define FLAG_UPDATE_NEW		0x01
#define FLAG_UPDATE_OLD		0xFF
#define FLAG_CONFIG_START	0xB0
#define FLAG_CONFIG_END		0xBF
#define CMD_GET_UPDATE  0xF1
#define CMD_SET_CONFIG  0xF2
#define CMD_GET_BOUNCE_DATA 0xF3
#define CMD_START       0xF5
#define CMD_STOP        0xF7
#define CMD_CHECK_CONN  0xFE
#define USB_CONFIG_LEN  34
#define USB_UPDATE_LEN  40
